ntobler/startracker/docs/arducam_imx462.md

# Arducam Starvis IMX462 Camera

Uses `Pivariety` driver from Arducam. Is part of the Raspberry Pi Kernel from `>6.1.21` on

https://docs.arducam.com/Raspberry-Pi-Camera/Pivariety-Camera/Introduction/
https://docs.arducam.com/Raspberry-Pi-Camera/Pivariety-Camera/IMX462/
https://docs.arducam.com/Raspberry-Pi-Camera/Pivariety-Camera/Quick-Start-Guide/
https://www.arducam.com/raspberry-pi-camera-pinout/
https://docs.arducam.com/Raspberry-Pi-Camera/Pivariety-Camera/PiCamera2-User-Guide/

# Raspberri pi camera API:
https://datasheets.raspberrypi.com/camera/picamera2-manual.pdf
https://github.com/raspberrypi/picamera2/blob/main/examples/stack_raw.py
