ntobler/startracker/docs/components.md

# Components

This document lists major components their specs and additional links.

Raspberry Pi Zero 2 W
- https://www.raspberrypi.com/products/raspberry-pi-zero-2-w/
- USD 16.50

SD Card:
- SanDisk Extreme UHS-I V30, 32 GB, microSDHC, U3

Camera
- Arcucam IMX462 Starvis
- https://www.uctronics.com/2mp-imx462-color-ultra-low-light-starvis-camera-module-with-141-h-wide-angle-m12-lens-for-raspberry-pi.html
- https://www.arducam.com/product/2mp-imx462-color-ultra-low-light-starvis-camera-module-with-141h-wide-angle-m12-lens-for-raspberry-pi/
- IMX462
- 1/2.8" (6.4mm diagonal)
- USD 39.99

Lens
- M12 12mm f2.0
- https://www.uctronics.com/arducam-12mm-m12-lens-m2512zh03-for-usb-camera.html
- https://aliexpress.com/item/1005004653999213.html
- 12mm f2.0
- max sensor size 1/2.5"
- USD 3.22

Lens Mount:
- Inner cutout: 12.5mm
- Screw-to-screw distance: 18mm
- Height: 12mm
- https://aliexpress.com/item/1005005308744888.html
- USD 0.80

Lens lock
- M12
- https://aliexpress.com/item/1005005929526811.html
- USD 1.21

https://www.aliexpress.com/item/32950560454.html

Cable
- 22pin MIPI FPC, 0.5mm pitch, 50mm length, Type B
- https://aliexpress.com/item/1005004140412156.html
- USD 1.82

Raspberry Pi Display
- https://aliexpress.com/item/32844614289.html
- USD 12.73

Raspberry Pi USP
- https://www.waveshare.com/ups-hat-c.htm
- USD 23.99

Total approx USD 100

# Enclosure:

Custom 3D printed parts

1/4" thread insert
- https://aliexpress.com/item/1005008462611857.html

# Rework with Radxa system

Radxa board
- https://aliexpress.com/item/1005008640313705.html
- USD 57.28

Radxa camera
- https://aliexpress.com/item/1005006991383002.html
- IMX415-Sensor
- 12.3 MP
- 1.45 um
- 1/2.8"
- USD 26.42
