ntobler/startracker/hardware/Startracker/Project Outputs for Startracker_mainboard/Release_A00/StartrackerA00_BOM.xlsx

Description | Designator | Footprint | #Column Name Error:' JLCPCB Part Number
Cap Cer SMD 100n 50V 10% 0603 X7R | C1, C5, C6, C7, C8, C10, C12, C14, C20, C21, C22, C35, C36, C37, C38, C39, C40, C41, C42, C48, C49, C50, C51, C52, C53, C54, C55 | C-0603_1608_095_L_RF
Cap Cer SMD 1u 16V 10% 0603 X7R | C2, C9, C18, C19, C32, C33, C34, C43, C44, C45 | C-0603_1608_095_L_RF
Cap Cer SMD 22u 25V 10% 1206 X5R | C3, C4, C15, C16, C17, C26, C27, C28, C29, C30, C31 | C-1206_3216_230_L_RF
Cap Cer SMD 22u 6.3V 20% 0603 X5R | C11, C13 | C-0603_1608_110_L_RF
Cap Cer SMD 22n 50V 10% 0603 X7R | C23, C24, C25 | C-0603_1608_095_L_RF
Cap Cer SMD 15p 50V 5% 0603 C0G | C46, C47 | C-0603_1608_095_L_RF
IC MCU Cortex-M4 256k Flash 128k RAM | D1 | UFQFPN48_N_RF
IC DRIVER Stepper 1.4A | D2, D3, D4 | QFN28_N_RF
IC Charger Li-Ion 1Cell | D5 | SOT23-6_N_RF
IC Protection Li-Ion | D6 | SOT23_N_RF
IC IMU 9-Axis Attitude Sensor | D7 | QFN24_N_RF
Crystal Oscillator 16MHz 10pF ±10ppm LCSC C112972 | G1 | G_3225_N_RF
IND 4.7uH 6.4A 4.9x4.9mm | L1 | L-0490X0490_N_RF
IND 4.7uH 2.9A 4x4mm | L2 | L-0400X0400_N_RF
<PCB DesignName Revision> | PCB1 | Dummy_PCB-Parameter_SM
Res SMD 10k 1% 0.1W 0603 | R1, R2, R3, R4, R7, R8, R10, R14, R20, R24, R25, R26, R27, R28, R30, R31, R34 | R-0603_1608_050_L_RF
Res SMD 5k1 1% 0.1W 0603 | R5, R6 | R-0603_1608_050_L_RF
Res SMD 1k 1% 0.1W 0603 | R9, R29 | R-0603_1608_050_L_RF
Res SMD 2k2 1% 0.1W 0603 | R11, R35, R36 | R-0603_1608_050_L_RF
Res SMD 100k 1% 0.1W 0603 | R12, R15, R17 | R-0603_1608_050_L_RF
Res SMD 100R 1% 0.1W 0603 | R13, R19 | R-0603_1608_050_L_RF
Res SMD 150k 1% 0.1W 0603 | R16 | R-0603_1608_050_L_RF
Res SMD 16k 1% 0.1W 0603 | R18 | R-0603_1608_050_L_RF
OLED Display I2C 128X64 0.96" | R21 | OLED_0.96
Res SMD 130k 1% 0.1W 0603 | R22 | R-0603_1608_050_L_RF
Res SMD 15k 1% 0.1W 0603 | R23 | R-0603_1608_050_L_RF
BUTTON tactile 12V 50mA | S1, S2, S3, S4 | K2-1808UN-A4SW-04
IC Boost Converter 1.8V-5.5V to 1.8-5.5V 2.1A | U1 | TSOT-23-8
IC Boost Converter 2.5V-5.5V upto 28V 1.5A | U2 | SOT23-5_N_RF
IC REG LDO 3.3V 200mA | U3 | SOT23_N_RF
LED RED LTST-C190KDKT-10A 0603 | V1 | LED-0603_1608_Red_L_RF
MOSFET PCH -2A 20V | V2, V4 | SOT23_N_RF
TRANS SMD NPN 45V 0.1A BC847B SOT23 | V3, V5 | SOT23_L_RF
Diode Schottky 40V 1A SMA | V6 | SMA_DO214AC_L_RF
RGB LED SPI Interface | V7 | V_2020_P6_N_RF
Diode Schottky 1mA 40 Volt | V13, V14 | SOD123_L_RF
CONN USB-C 16pin | X1 | 105450-0101
CONN HEADER 4POS_JST_B4B-XH | X3, X4, X6, X8 | X-0124X0057-R_M04_P0250_JST_B4B-XH-A
CONN HEADER 2POS_JST_B2B-XH | X5 | X-0074X0057-R_M02_P0250_JST_B2B-XH-A
