ntobler/startracker/hardware/Startracker/Project Outputs for Startracker_mainboard/Release_A00/Startracker_A00_SCH.PDF

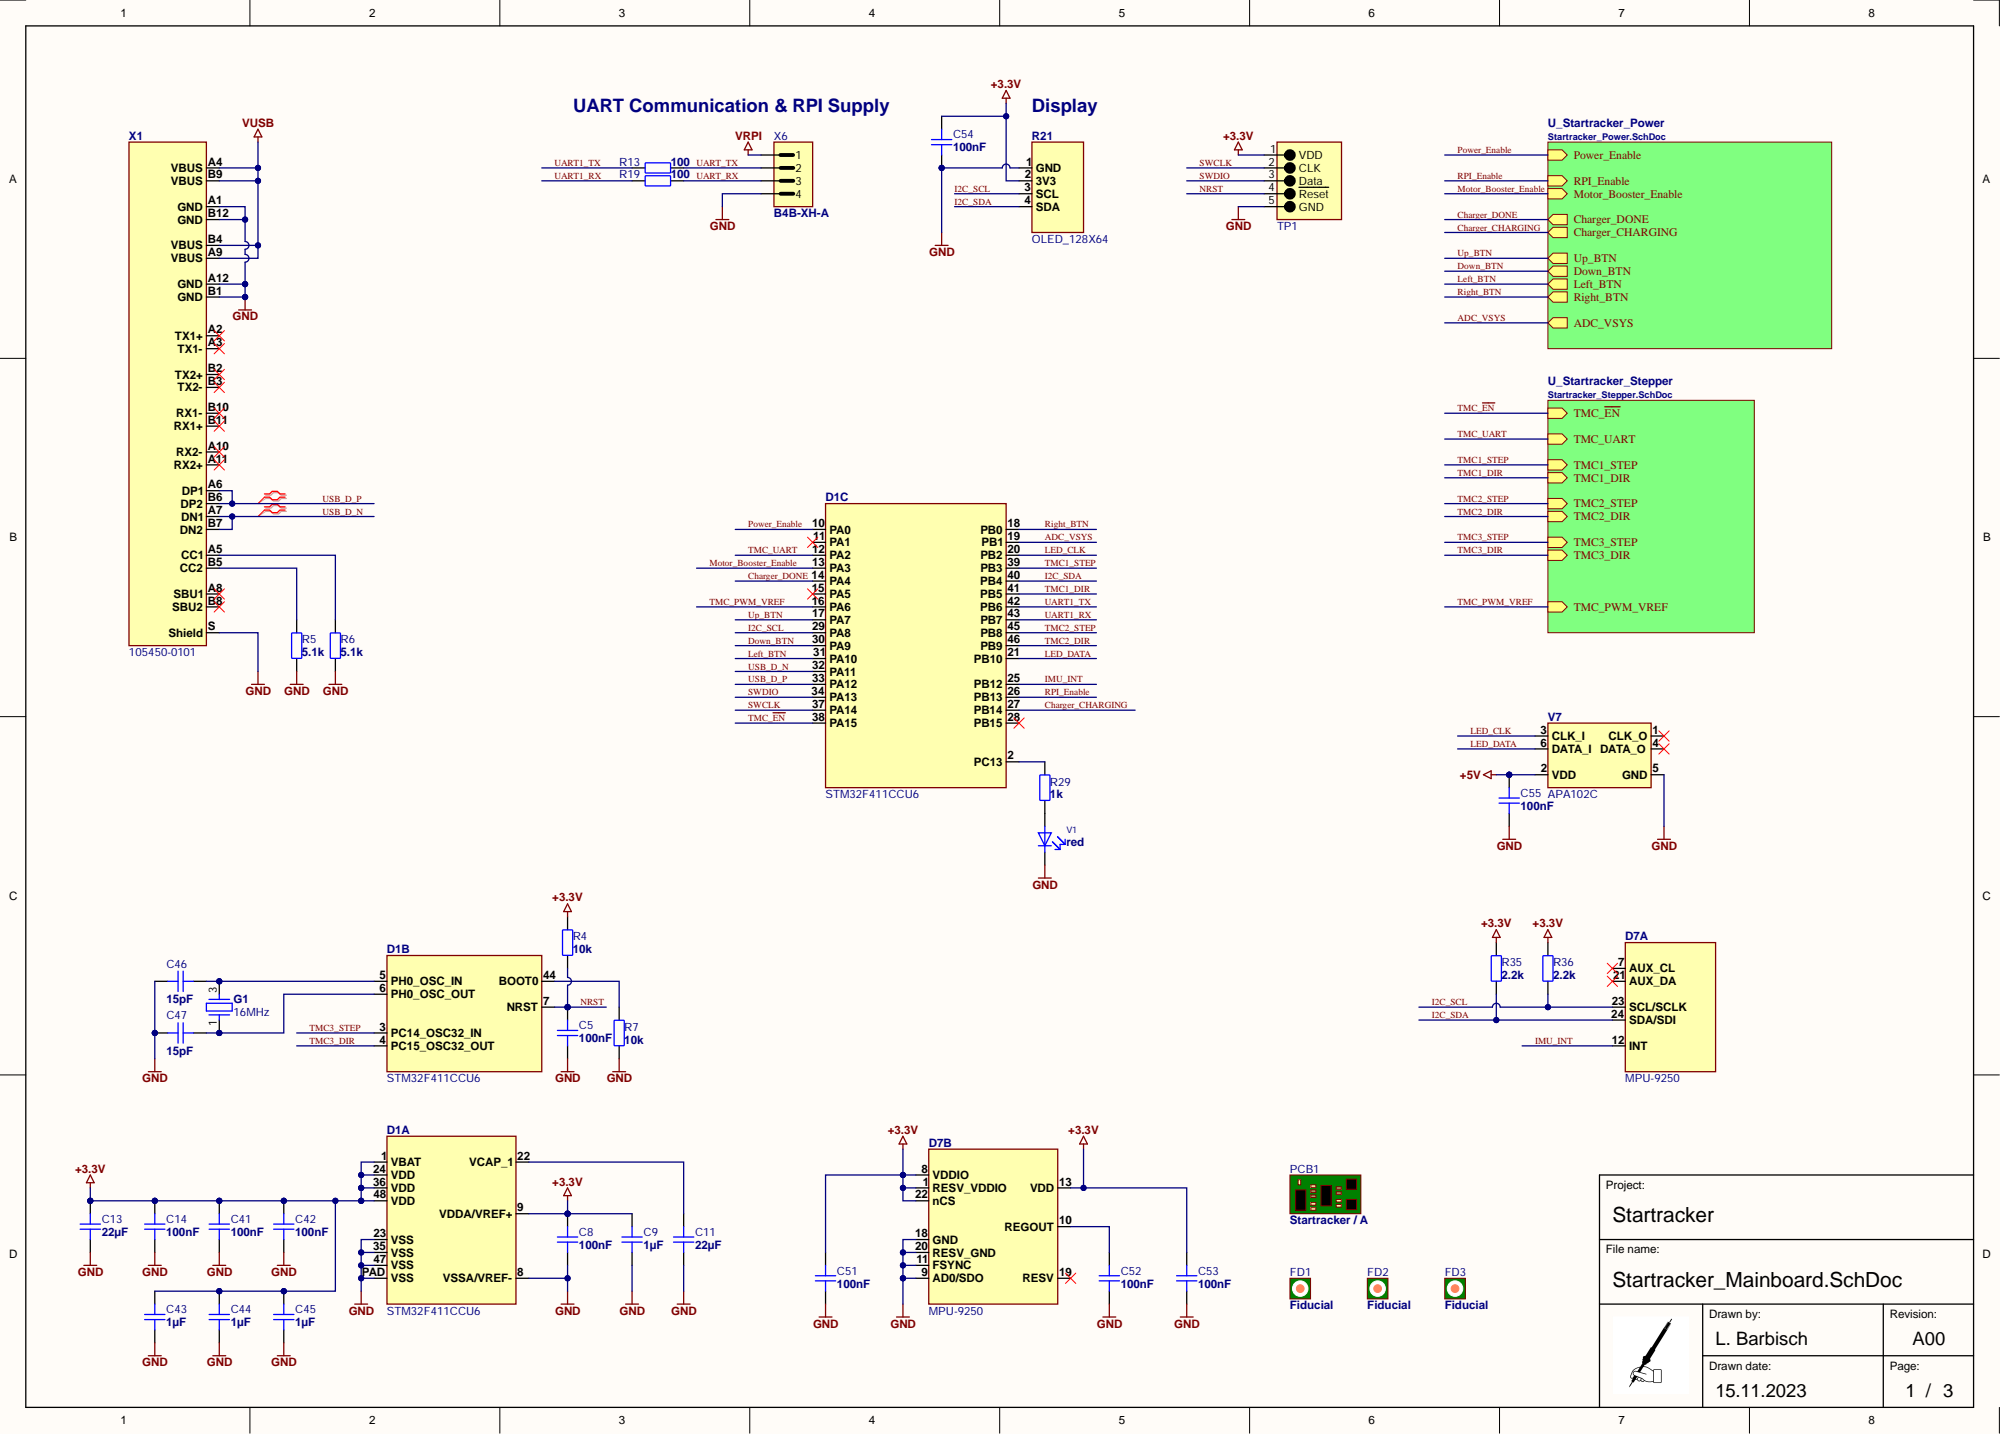
[picture p3: page 1]

UART Communication & RPI Supply

Drawn by: L. Barbisch | Revision: A00

Drawn date: 15.11.2023 | Page:

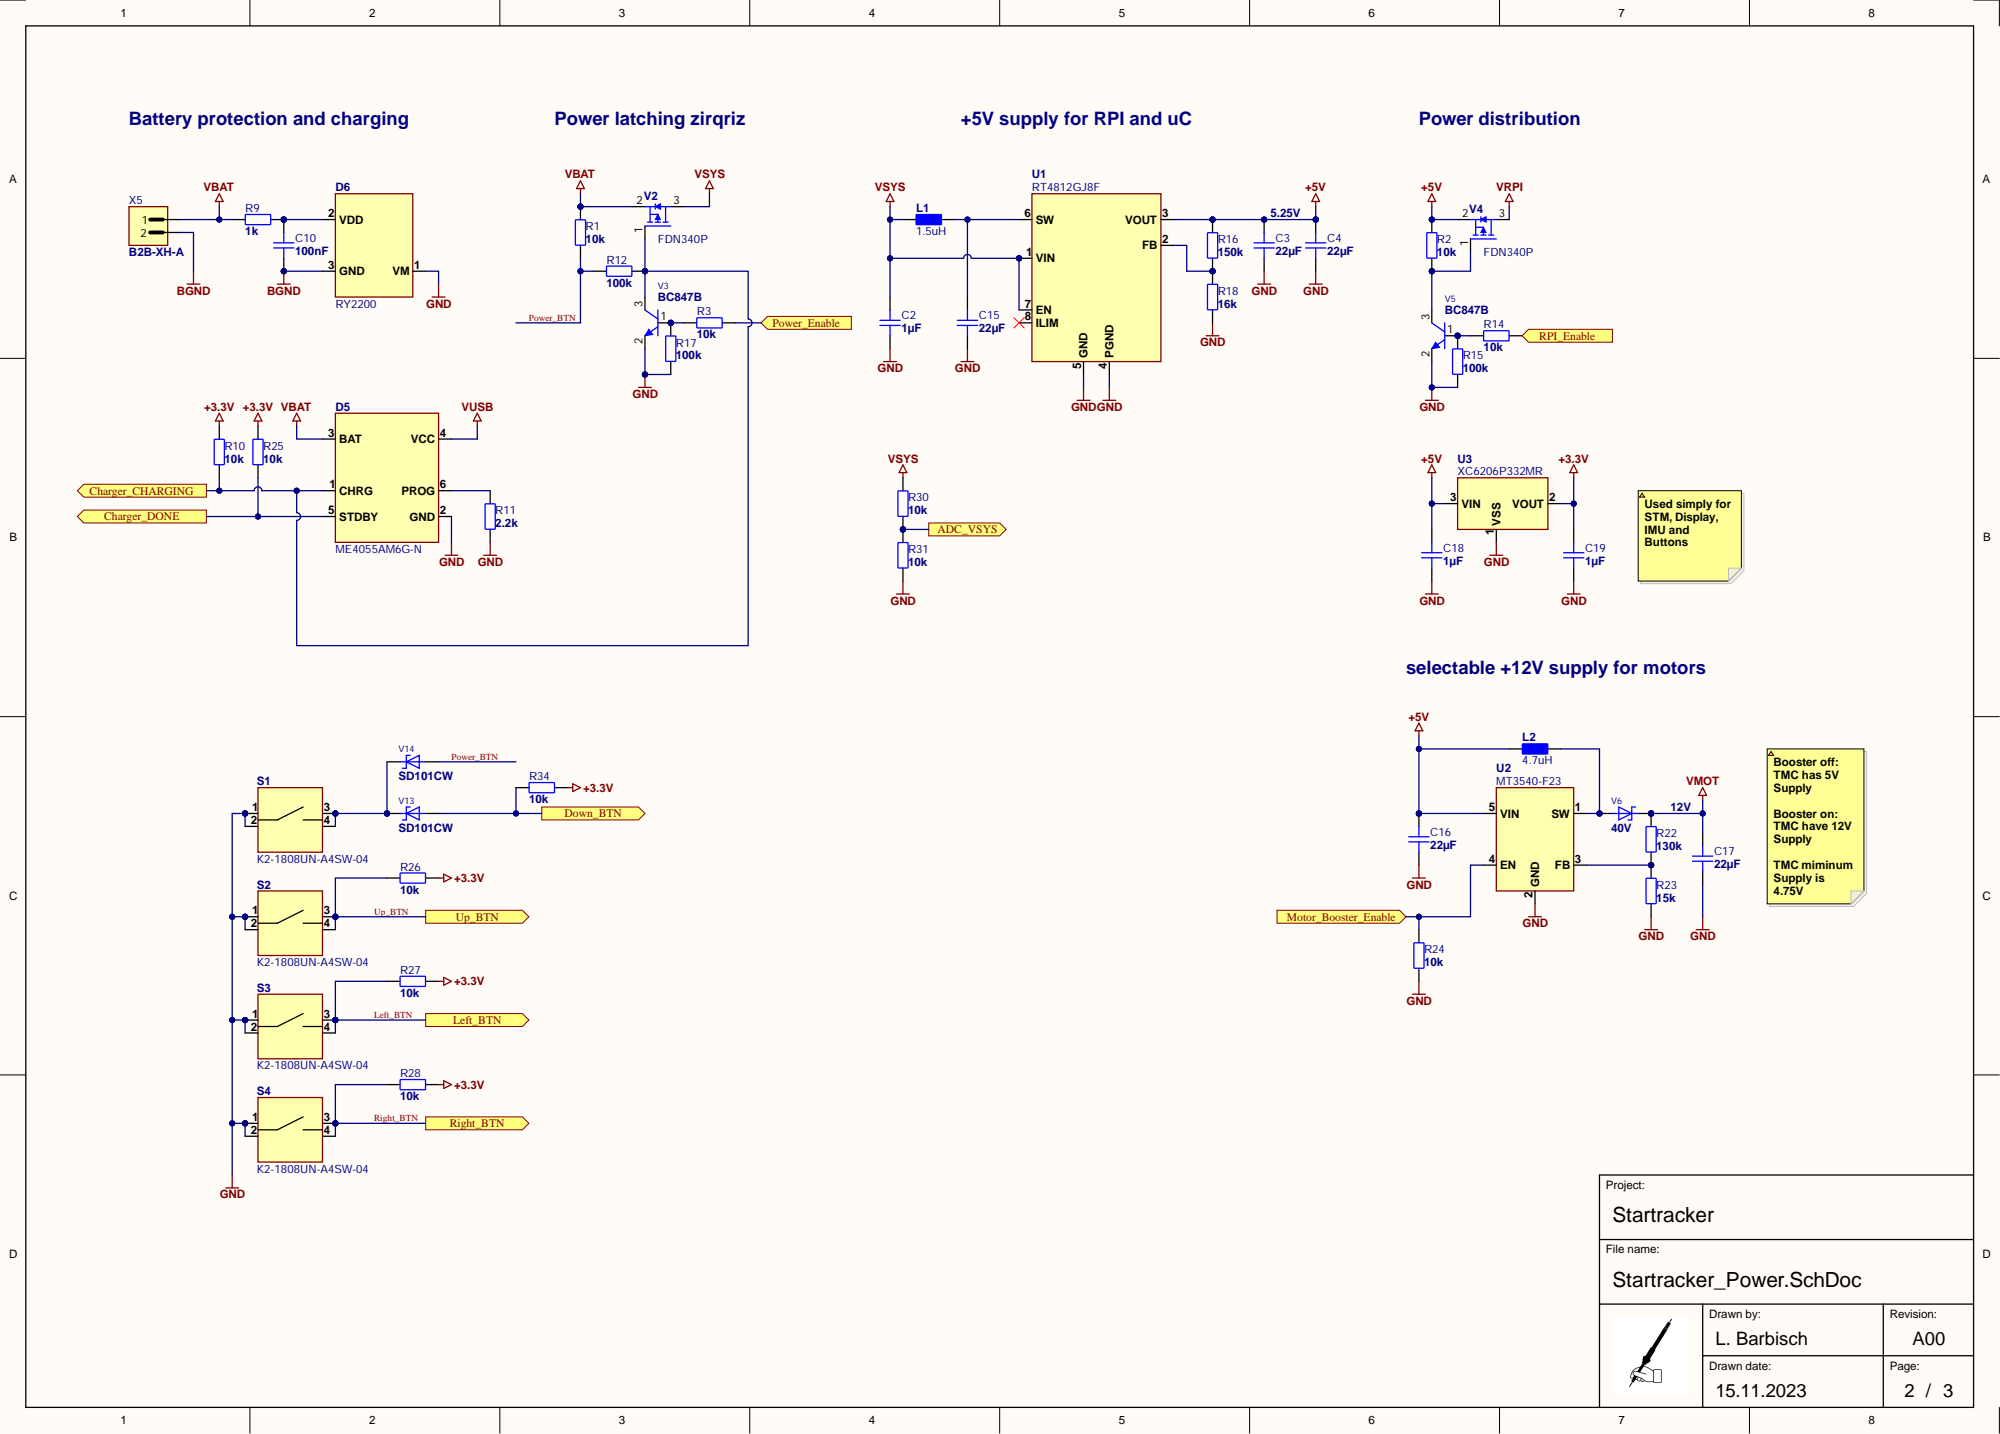
[picture p4: page 2]

Battery protection and charging

+5V supply for RPI and uC

selectable +12V supply for motors

Revision: A00

15.11.2023 | Page:

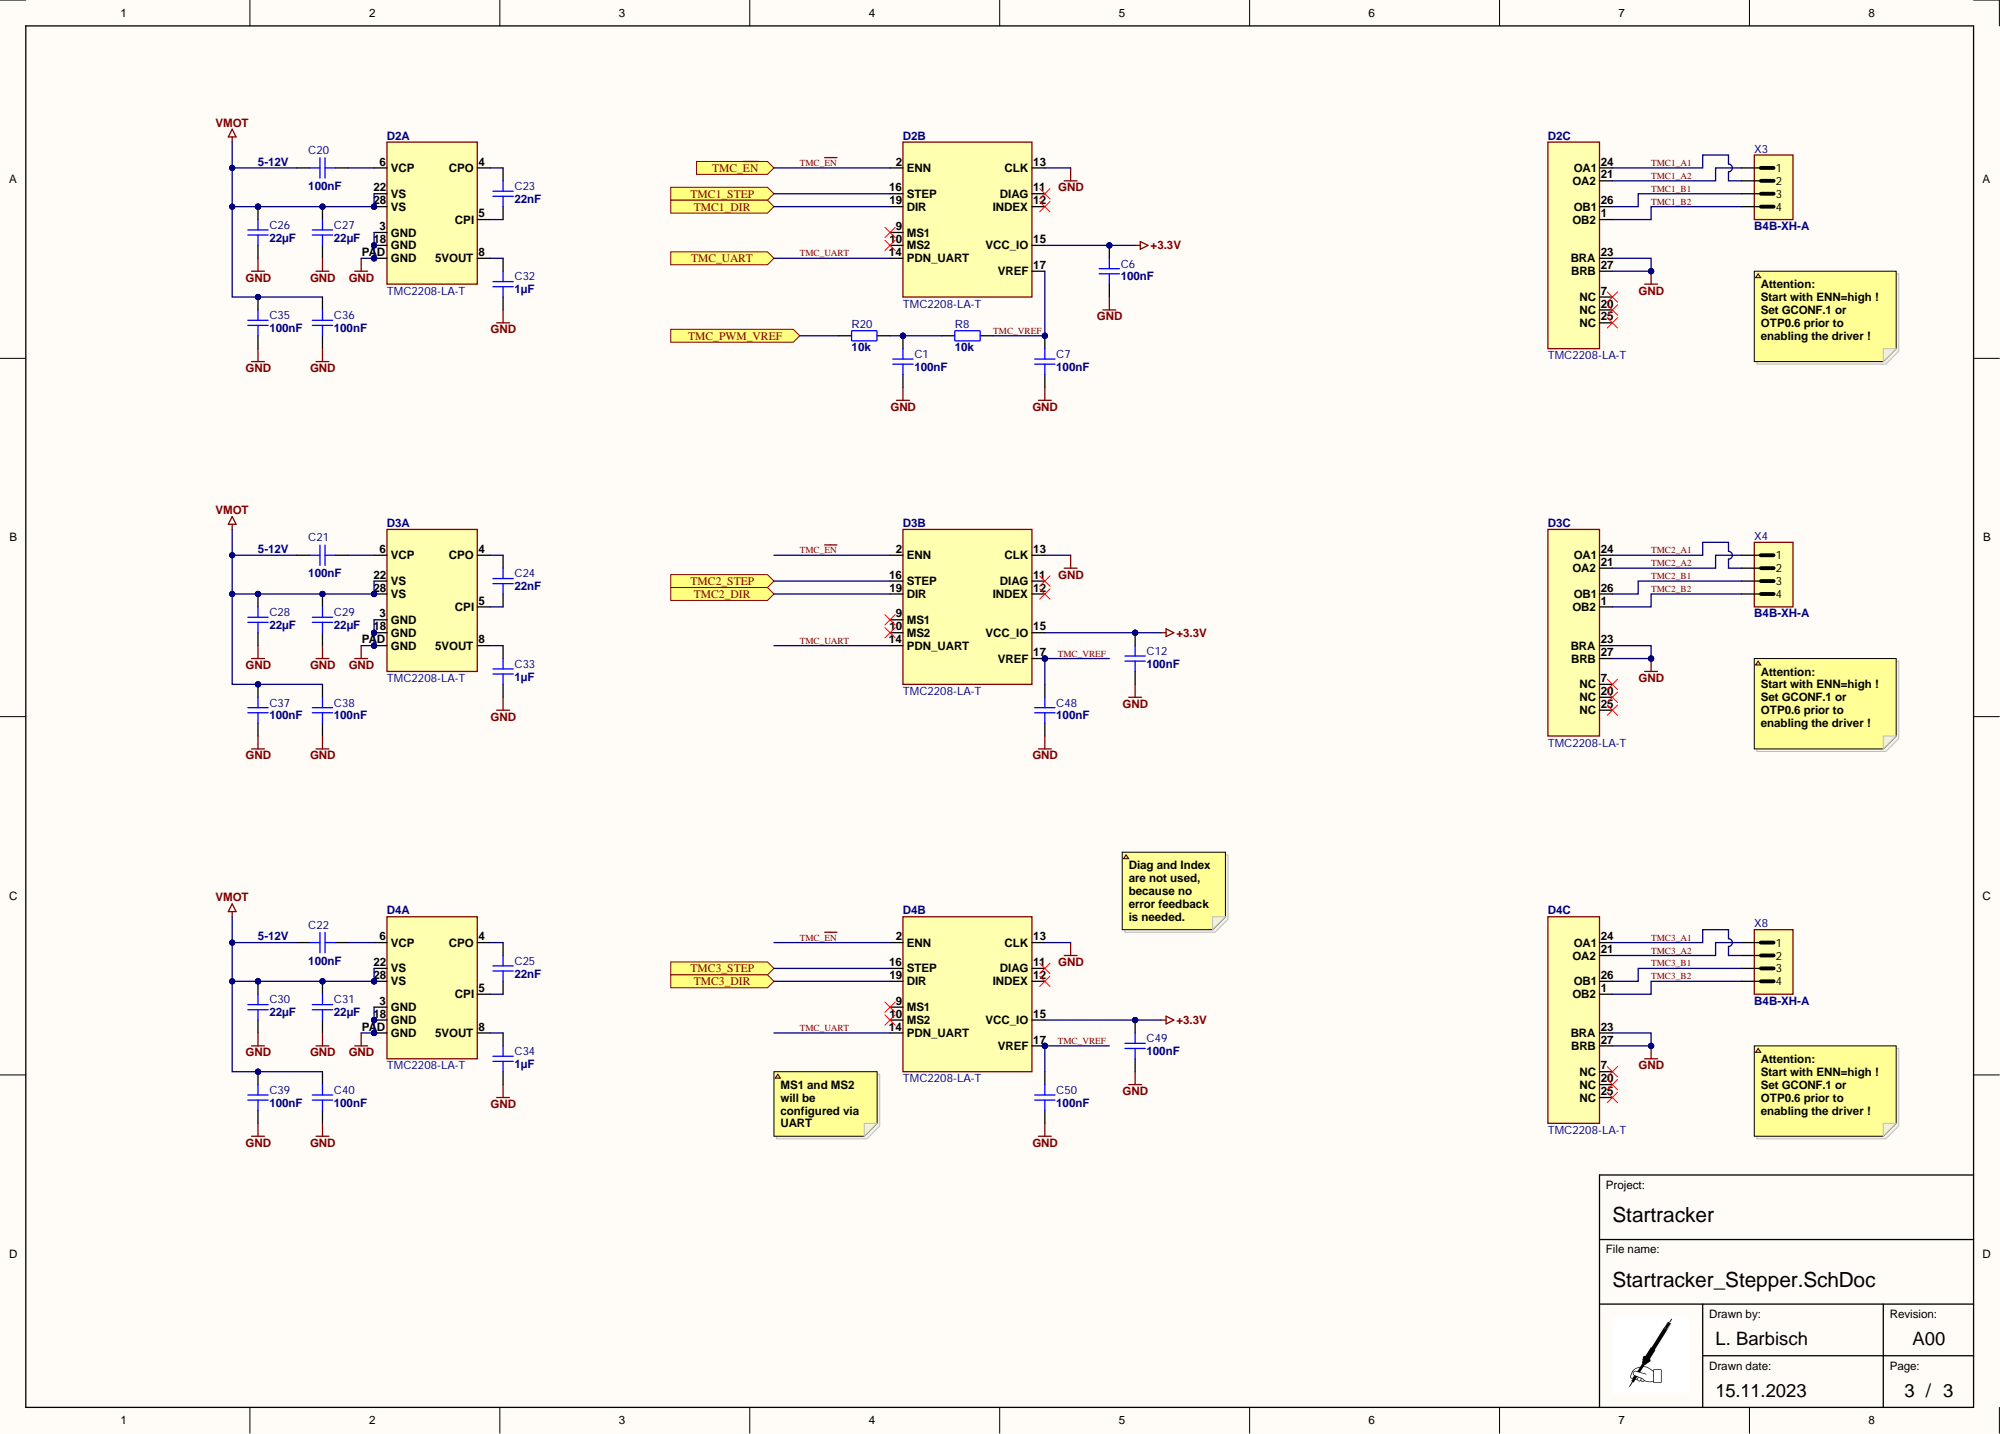
[picture p5: page 3]

Attention
Start with ENN=high
Set GCONF.1 or
OTP0.6 prior to
enabling the driver

Revision : A00 3

Page : /
