ntobler/startracker/hardware/Startracker/Project Outputs for Startracker_mainboard/Release_A00/Startracker_A00_Documentation.PDF

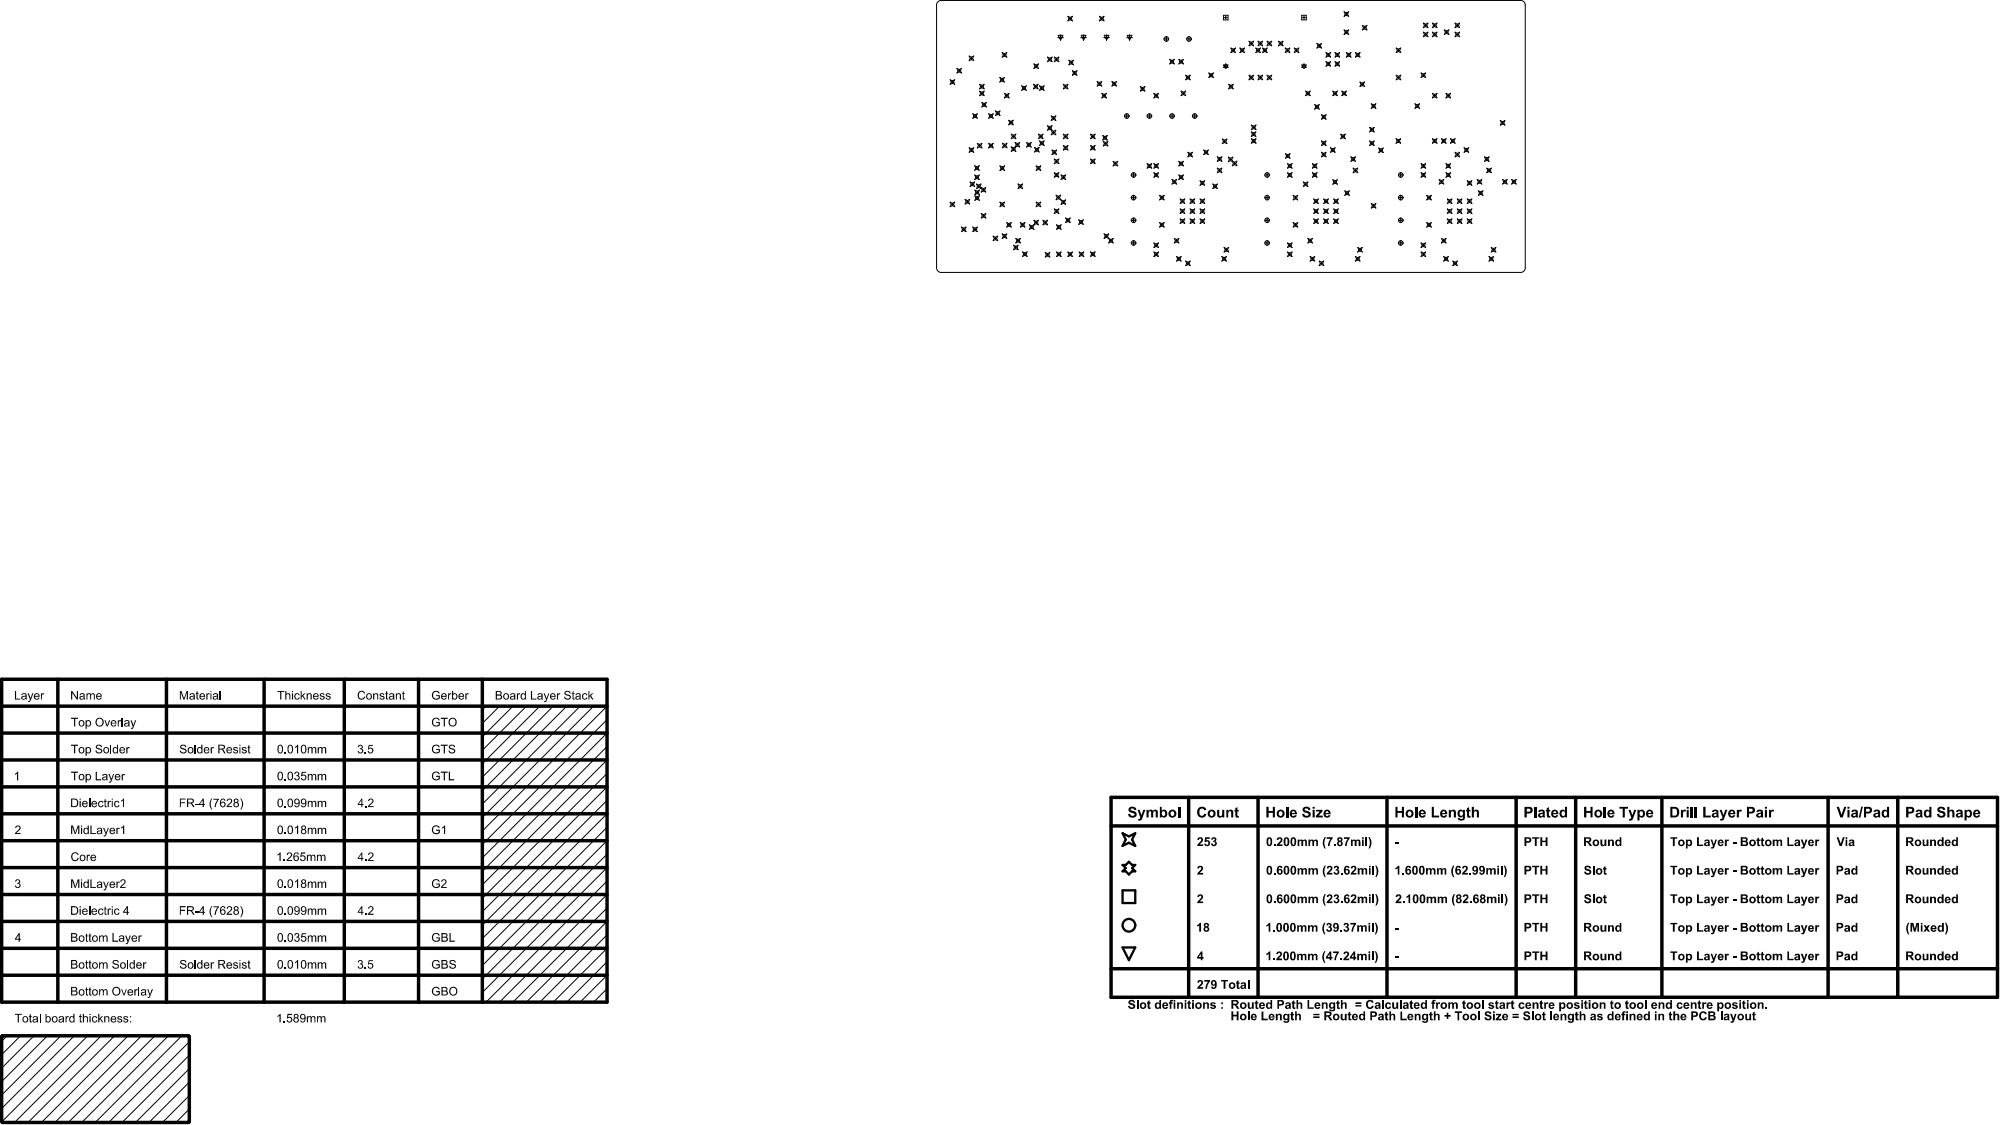
[picture p6: page 2]

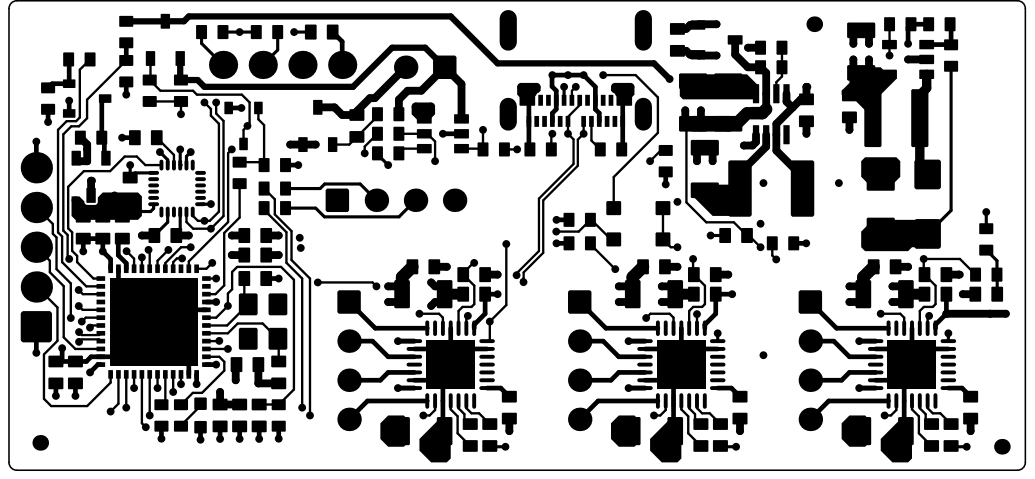
[picture p7: page 3]

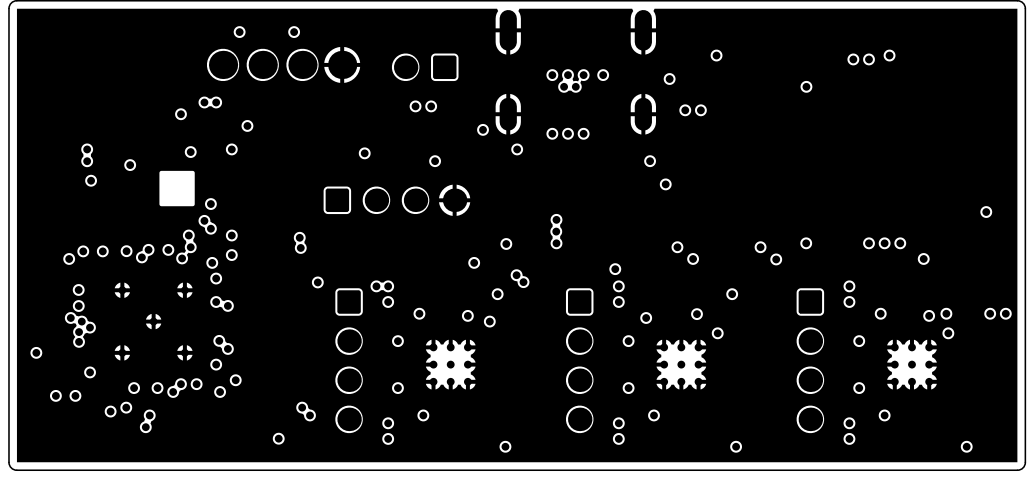
[picture p8: page 4]

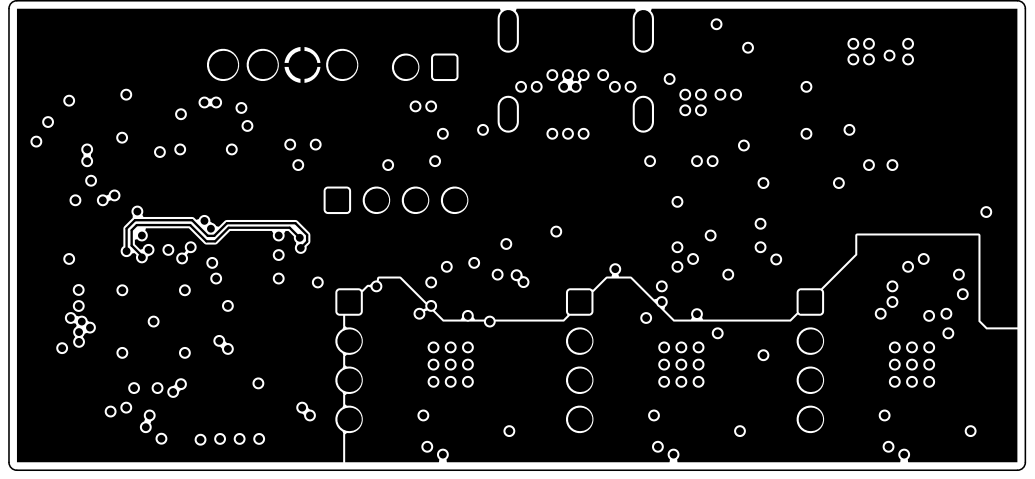
[picture p9: page 5]

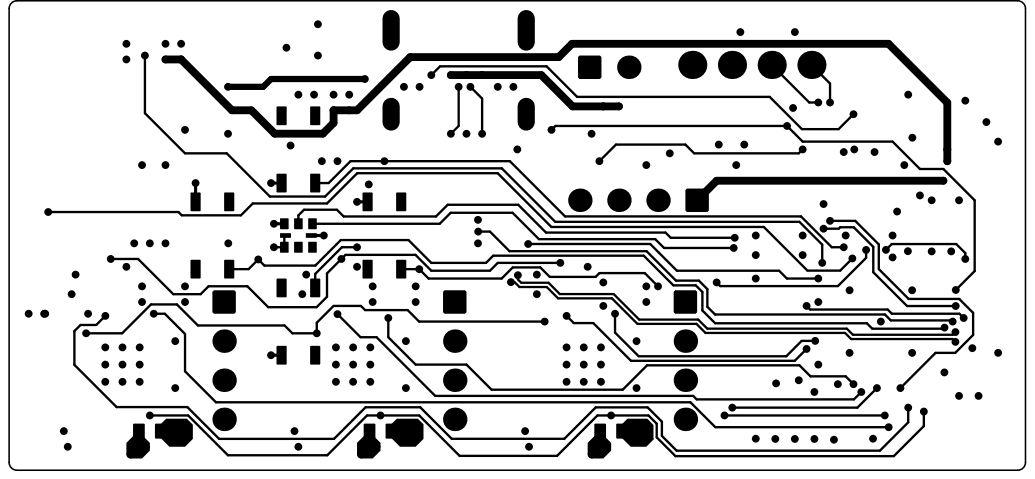
[picture p10: page 8]
