ntobler/startracker/hardware/Startracker/Project Outputs for Startracker_mainboard/Release_A00/Startracker_A00_Testpoints.PDF

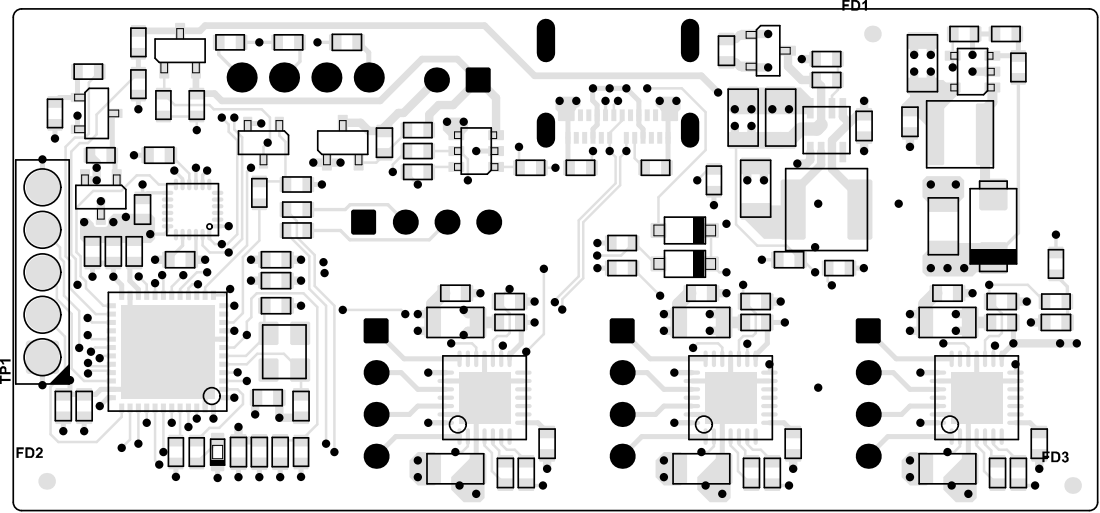
[picture p17: page 1]

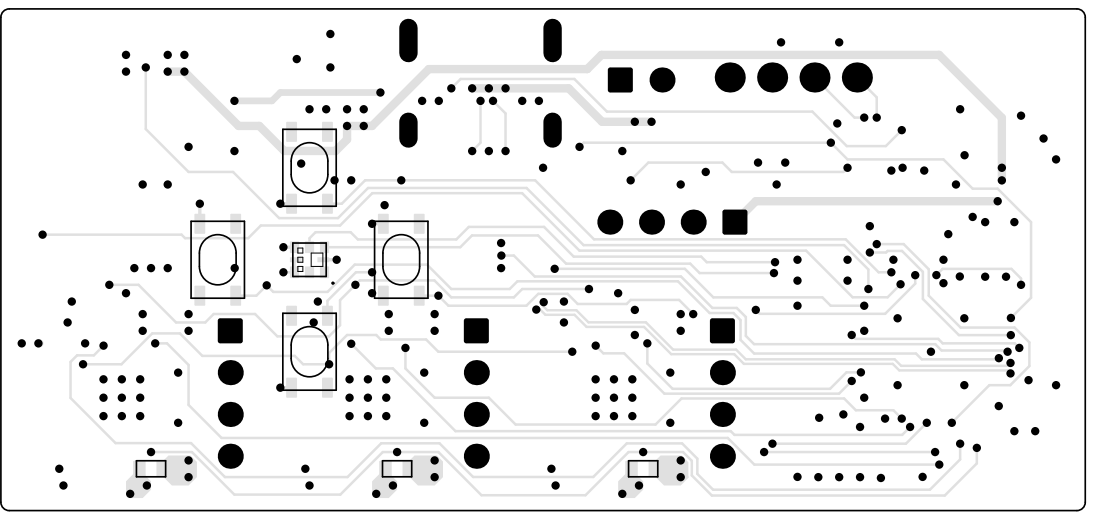
[picture p18: page 2]
