ntobler/startracker/(list of files, drawings)

Other design files:
hardware/Startracker/Startracker_mainboard.PrjPcb
hardware/Startracker/Startracker_Mainboard.SchDoc
hardware/Startracker/Startracker_Power.SchDoc
hardware/Startracker/Startracker_Stepper.SchDoc
