ntobler/startracker/src/lib.rs

use numpy::{self, PyArrayMethods, PyUntypedArrayMethods, ToPyArray};
use pyo3::Python;
use pyo3::{
    exceptions::PyRuntimeError, pyclass, pyfunction, pymethods, pymodule, types::PyModule,
    wrap_pyfunction, Bound, PyResult,
};
use std::usize;

use crate::optim::OptimizableProblem;

mod common_axis;
mod optim;
mod poisson_disk;
mod quat_optim;
mod starcal;
mod stargradcal;
mod testingutils;
mod utils;

pub mod cam;

#[pymodule]
fn libstartracker(m: &Bound<'_, PyModule>) -> PyResult<()> {
    m.add_function(wrap_pyfunction!(starcal_calibrate, m)?)?;
    m.add_function(wrap_pyfunction!(starcal_objective_function, m)?)?;
    m.add_function(wrap_pyfunction!(stargradcal_calibrate, m)?)?;
    m.add_function(wrap_pyfunction!(stargradcal_objective_function, m)?)?;
    m.add_function(wrap_pyfunction!(find_common_axis, m)?)?;
    m.add_function(wrap_pyfunction!(even_spaced_indices, m)?)?;
    m.add_class::<StarcalCalibrationResult>()?;
    m.add_class::<CameraConfig>()?;
    m.add_class::<Camera>()?;
    m.add_function(wrap_pyfunction!(estimate_gyro_params, m)?)?;
    m.add_function(wrap_pyfunction!(filter_step, m)?)?;
    Ok(())
}

#[pyclass]
pub struct StarcalCalibrationResult {
    inner: starcal::CalibrationResult,
}

#[pymethods]
impl StarcalCalibrationResult {
    #[getter]
    pub fn params(&self) -> Vec<f64> {
        self.inner.params.to_vec()
    }

    #[getter]
    pub fn rms_error(&self) -> f64 {
        self.inner.rms_error
    }

    // Prevent construction from Python
    #[new]
    fn new() -> PyResult<Self> {
        Err(PyRuntimeError::new_err(
            "StarcalCalibrationResult cannot be constructed from Python",
        ))
    }
}

#[pyfunction]
fn starcal_objective_function<'py>(
    py: Python<'py>,
    params: [f64; starcal::PARAM_COUNT],
    image_points: numpy::PyReadonlyArray2<'py, f32>,
    object_points: numpy::PyReadonlyArray2<'py, f32>,
) -> PyResult<(
    Bound<'py, numpy::PyArray1<f64>>,
    Bound<'py, numpy::PyArray2<f64>>,
)> {
    let image_points_view = numpy_to_slice_2d(&image_points)?;
    let object_points_view = numpy_to_slice_2d(&object_points)?;
    let mut problem: starcal::CameraCalibrationProblem<'_> =
        starcal::CameraCalibrationProblem::new(&params, image_points_view, object_points_view);

    problem.calc_jacobian();
    problem.calc_residuals();

    let residuals = problem.get_residuals().as_slice().to_pyarray_bound(py);
    let jacobian_array = problem.get_jacobian();
    let jacobian_flat = jacobian_array.as_slice().to_pyarray_bound(py);
    let jacobian = jacobian_flat.reshape((jacobian_array.ncols(), jacobian_array.nrows()))?;
    Ok((residuals, jacobian))
}

#[pyfunction]
fn starcal_calibrate<'py>(
    image_points: numpy::PyReadonlyArray2<'py, f32>,
    object_points: numpy::PyReadonlyArray2<'py, f32>,
    image_size: [usize; 2],
    intrinsic_guess: Option<numpy::PyReadonlyArray2<'py, f64>>,
    dist_coefs_guess: Option<numpy::PyReadonlyArray1<'py, f64>>,
    tol: Option<f64>,
    max_iter: Option<usize>,
) -> PyResult<StarcalCalibrationResult> {
    let image_points_view = numpy_to_slice_2d(&image_points)?;
    let object_points_view = numpy_to_slice_2d(&object_points)?;

    let intrinsic: [[f64; 3]; 3] = if let Some(guess) = intrinsic_guess {
        if guess.shape() != [3, 3] {
            return Err(PyRuntimeError::new_err(
                "intrinsic_guess must have shape [3, 3]",
            ));
        }
        let slice = guess.as_slice()?;
        [
            [slice[0], 0.0, slice[2]],
            [0.0, slice[4], slice[5]],
            [0.0, 0.0, 1.0],
        ]
    } else {
        let width = image_size[0] as f64;
        let height = image_size[1] as f64;
        let min_z = object_points_view
            .iter()
            .map(|p| p[2])
            .fold(f32::INFINITY, f32::min) as f64;
        let focal_length =
            f64::sqrt(width * width + height * height) / f64::tan(f64::acos(min_z)) / 2.0;
        [
            [focal_length, 0.0, width / 2.0],
            [0.0, focal_length, height / 2.0],
            [0.0, 0.0, 1.0],
        ]
    };
    let dist_coefs: [f64; 5] = if let Some(guess) = dist_coefs_guess {
        let slice = guess.as_slice()?;
        if slice.len() != 5 {
            return Err(PyRuntimeError::new_err(
                "dist_coefs_guess must have length 5",
            ));
        }
        [slice[0], slice[1], slice[2], slice[3], slice[4]]
    } else {
        [0.0, 0.0, 0.0, 0.0, 0.0]
    };

    let tol_value = match tol {
        Some(v) => v,
        None => 1e-4,
    };

    let max_iter_value = match max_iter {
        Some(v) => v,
        None => 20,
    };

    let result = starcal::calibrate(
        image_points_view,
        object_points_view,
        &intrinsic,
        &dist_coefs,
        tol_value,
        max_iter_value,
    );

    Ok(StarcalCalibrationResult { inner: result })
}

#[pyfunction]
fn stargradcal_objective_function<'py>(
    py: Python<'py>,
    image_points: numpy::PyReadonlyArray2<'py, f32>,
    image_gradients: numpy::PyReadonlyArray2<'py, f32>,
    intrinsic_guess: numpy::PyReadonlyArray2<'py, f64>,
    dist_coef_guess: f64,
    theta_guess: f64,
    epsilon_guess: f64,
) -> PyResult<(
    Bound<'py, numpy::PyArray1<f64>>,
    Bound<'py, numpy::PyArray2<f64>>,
)> {
    let image_points_view = numpy_to_slice_2d(&image_points)?;
    let image_gradients_view = numpy_to_slice_2d(&image_gradients)?;

    if intrinsic_guess.shape() != [3, 3] {
        return Err(PyRuntimeError::new_err(
            "intrinsic_guess must have shape [3, 3]",
        ));
    }
    let slice = intrinsic_guess.as_slice()?;
    let intrinsic = [
        [slice[0], slice[1], slice[2]],
        [slice[3], slice[4], slice[5]],
        [slice[6], slice[7], slice[8]],
    ];

    let params = [
        f64::tan(epsilon_guess * 0.25),
        f64::tan(theta_guess * 0.25),
        intrinsic[0][0],
        intrinsic[0][2],
        intrinsic[1][1],
        intrinsic[1][2],
        dist_coef_guess,
    ];

    let mut problem: stargradcal::StarGradCalibrationProblem<'_> =
        stargradcal::StarGradCalibrationProblem::new(
            &params,
            image_points_view,
            image_gradients_view,
        );

    problem.calc_jacobian();
    problem.calc_residuals();

    let residuals = problem.get_residuals().as_slice().to_pyarray_bound(py);
    let jacobian_flat = problem.get_jacobian().as_slice().to_pyarray_bound(py);
    let jacobian = jacobian_flat
        .reshape((
            problem.get_jacobian().ncols(),
            problem.get_jacobian().nrows(),
        ))
        .expect("Shape mismatch in jacobian reshape");
    Ok((residuals, jacobian))
}

#[pyfunction]
fn find_common_axis<'py>(
    py: Python<'py>,
    rot_mats: numpy::PyReadonlyArray2<'py, f64>,
    tol: f64,
    max_iter: usize,
) -> PyResult<(
    Bound<'py, numpy::PyArray1<f64>>,
    Bound<'py, numpy::PyArray1<f64>>,
    Bound<'py, numpy::PyArray1<f64>>,
    f64,
)> {
    let rot_mats_view: &[[f64; 9]] = numpy_to_slice_2d(&rot_mats)?;
    let (axis, mrp, residuals, estimated_std_rad) =
        common_axis::find_common_axis(rot_mats_view, tol, max_iter)
            .map_err(PyRuntimeError::new_err)?;
    let axis_np = axis.as_slice().to_pyarray_bound(py);
    let mrp_np = mrp.as_slice().to_pyarray_bound(py);
    let residuals_np = residuals.as_slice().to_pyarray_bound(py);
    Ok((axis_np, mrp_np, residuals_np, estimated_std_rad))
}

#[pyfunction]
fn stargradcal_calibrate<'py>(
    py: Python<'py>,
    image_points: numpy::PyReadonlyArray2<'py, f32>,
    image_gradients: numpy::PyReadonlyArray2<'py, f32>,
    intrinsic_guess: numpy::PyReadonlyArray2<'py, f64>,
    dist_coef_guess: f64,
    theta_guess: f64,
    epsilon_guess: f64,
    tol: f64,
    max_iter: usize,
) -> PyResult<(
    Bound<'py, numpy::PyArray2<f64>>,
    f64,
    f64,
    f64,
    Bound<'py, numpy::PyArray1<f64>>,
)> {
    let image_points_view = numpy_to_slice_2d(&image_points)?;
    let image_gradients_view = numpy_to_slice_2d(&image_gradients)?;

    if intrinsic_guess.shape() != [3, 3] {
        return Err(PyRuntimeError::new_err(
            "intrinsic_guess must have shape [3, 3]",
        ));
    }
    let slice = intrinsic_guess.as_slice()?;
    let intrinsic = [
        [slice[0], 0.0, slice[2]],
        [0.0, slice[4], slice[5]],
        [0.0, 0.0, 1.0],
    ];

    let (intrinsic, dist_coef, theta, epsilon, residuals) = stargradcal::calibrate(
        image_points_view,
        image_gradients_view,
        &intrinsic,
        dist_coef_guess,
        theta_guess,
        epsilon_guess,
        tol,
        max_iter,
    );

    let intrinsic_numpy_flat = intrinsic.as_slice().to_pyarray_bound(py);
    let residuals_numpy = residuals.as_slice().to_pyarray_bound(py);
    // nalgebra is row-major, numpy expects column-major, so we need to transpose
    let intrinsic_numpy = intrinsic_numpy_flat
        .reshape((3, 3))
        .expect("Shape mismatch in intrinsic reshape");

    Ok((intrinsic_numpy, dist_coef, theta, epsilon, residuals_numpy))
}

#[pyfunction]
fn even_spaced_indices<'py>(
    py: Python<'py>,
    points: numpy::PyReadonlyArray2<'py, f32>,
    n_samples: usize,
    rng_seed: u64,
) -> PyResult<Bound<'py, numpy::PyArray1<usize>>> {
    let points_view = numpy_to_slice_2d(&points)?;
    let accepted_indices = poisson_disk::even_spaced_indices(&points_view, n_samples, rng_seed);
    Ok(accepted_indices.as_slice().to_pyarray_bound(py))
}

fn numpy_to_slice_2d<'py, T: numpy::Element + Copy, const L: usize>(
    vectors: &'py numpy::PyReadonlyArray2<'py, T>,
) -> PyResult<&'py [[T; L]]> {
    if !vectors.is_c_contiguous() || vectors.ndim() != 2 || vectors.shape()[1] != L {
        return Err(PyRuntimeError::new_err(format!(
            "vectors must be a c_contiguous array with shape=[n, {}]",
            L
        )));
    }
    let slice = vectors.as_slice()?;
    Ok(unsafe { std::slice::from_raw_parts(slice.as_ptr() as *const [T; L], slice.len() / L) })
}

#[pyclass]
struct CameraConfig {
    inner: cam::CameraConfig,
}

#[pymethods]
impl CameraConfig {
    #[new]
    fn new(
        analogue_gain: u32,
        digital_gain: u32,
        exposure_us: u32,
        binning: u32,
    ) -> PyResult<Self> {
        let config = cam::CameraConfig {
            analogue_gain,
            digital_gain,
            exposure_us,
            binning,
        };
        Ok(CameraConfig { inner: config })
    }
}

#[pyclass]
struct Camera {
    inner: cam::Camera,
}

#[pymethods]
impl Camera {
    #[new]
    fn new(config: &CameraConfig) -> PyResult<Self> {
        let camera = cam::Camera::new(&config.inner).map_err(PyRuntimeError::new_err)?;
        Ok(Camera { inner: camera })
    }

    pub fn set_config(&mut self, config: &CameraConfig) {
        self.inner.set_config(&config.inner)
    }

    pub fn capture<'py>(&mut self, py: Python<'py>) -> PyResult<Bound<'py, numpy::PyArray2<u8>>> {
        let frame: cam::Frame<u8> = self.inner.capture().map_err(PyRuntimeError::new_err)?;
        let np_array = frame.data_row_major.to_pyarray_bound(py);
        let np_array = np_array
            .reshape((frame.height, frame.width))
            .expect("Shape mismatch in reshape");
        Ok(np_array)
    }
}

#[pyfunction]
fn estimate_gyro_params<'py>(
    py: Python<'py>,
    q_0: [f64; 4],
    q_1: [f64; 4],
    omega_t: numpy::PyReadonlyArray2<'py, f64>,
    scales: [f64; 3],
    biases: [f64; 3],
    delta_t: f64,
) -> PyResult<(
    Bound<'py, numpy::PyArray1<f64>>,
    Bound<'py, numpy::PyArray2<f64>>,
    Bound<'py, numpy::PyArray1<f64>>,
)> {
    let omega_t_view: &[[f64; 3]] = numpy_to_slice_2d(&omega_t)?;
    let (residuals, jacobian, q_x) =
        quat_optim::objective_function(&q_0, &q_1, omega_t_view, scales, biases, delta_t);

    let residuals_np = residuals.as_slice().to_pyarray_bound(py);
    let jacobian_np = jacobian.transpose().as_slice().to_pyarray_bound(py);
    let jacobian_np = jacobian_np.reshape((jacobian.nrows(), jacobian.ncols()))?;
    let q_x_np = q_x.as_slice().to_pyarray_bound(py);

    Ok((residuals_np, jacobian_np, q_x_np))
}

#[pyfunction]
fn filter_step<'py>(
    py: Python<'py>,
    q_0: [f64; 4],
    q_1: [f64; 4],
    omega_t: numpy::PyReadonlyArray2<'py, f64>,
    scales: [f64; 3],
    biases: [f64; 3],
    delta_t: f64,
    lamb: f64,
    alpha: f64,
    trust_region: f64,
) -> PyResult<(
    Bound<'py, numpy::PyArray1<f64>>,
    Bound<'py, numpy::PyArray1<f64>>,
)> {
    let omega_t_view: &[[f64; 3]] = numpy_to_slice_2d(&omega_t)?;
    let (scales, biases) = quat_optim::filter_step(
        &q_0,
        &q_1,
        omega_t_view,
        scales,
        biases,
        delta_t,
        lamb,
        alpha,
        trust_region,
    );

    let scales_np = scales.as_slice().to_pyarray_bound(py);
    let biases_np = biases.as_slice().to_pyarray_bound(py);
    Ok((scales_np, biases_np))
}
