ntobler/startracker/startracker/communication.py

"""Module to handle serial communication."""

import abc
import contextlib
import dataclasses
import enum
import logging
import pathlib
import struct
from collections.abc import Sequence
from typing import Any, Generic, Literal, Optional, TypeAlias, TypeVar, Union

import numpy as np
import serial
import serial.serialutil
from typing_extensions import Self, override


class CommunicatinoError(Exception):
    """Base class for communication errors."""


class CommunicationTimeoutError(CommunicatinoError):
    """Raised when a timeout happens during communication."""


class CRCError(CommunicatinoError):
    """Raised when a CRC check fails."""


def calc_crc_ccitt(data: bytes) -> int:
    """Calculate CRC-16/CCITT-FALSE of the data.

    Poly=0x1021, Init=0xFFFF, RefIn=False, RefOut=False, XorOut=0x0000

    Args:
        data: input data

    Returns:
        int: crc of the data
    """
    crc = 0xFFFF
    for x in data:
        crc ^= x << 8
        for _ in range(8):
            crc = (crc * 2) ^ 0x1021 if crc & 0x8000 else crc * 2
    return crc & 0xFFFF


def calc_crc_ibm(data: bytes) -> int:
    """Calculate CRC-16-IBM of the data as used in MODBUS .

    Poly=0x8005, Init=0xFFFF, RefIn=True, RefOut=True, XorOut=0x0000

    Args:
        data: input data

    Returns:
        int: crc of the data
    """
    crc = 0xFFFF
    for x in data:
        crc ^= x
        for _ in range(8):
            crc = (crc // 2) ^ 0xA001 if crc & 0x0001 else crc // 2
    return crc & 0xFFFF


class PacketHandler(serial.Serial):
    """Receive and send protocol packets.

    Properties:
    - Big endian

    Packet structure
    - 1 cmd_id byte
    - 1 length byte, evaluates to n
    - n payload bytes
    - 2 crc bytes of payload only (crc16)
    """

    def __init__(self, ser: serial.Serial) -> None:
        self._ser = ser

    def read_cmd(self) -> tuple[int, bytes]:
        """Read serial command from the input buffer.

        Raises:
            CommunicationTimeoutException if timeouts happen.

        Returns:
            tuple[int, bytes]:
                - Command id
                - Payload bytes
        """
        timeout_time = self._ser.timeout if self._ser.timeout is not None else 999
        timeout = serial.serialutil.Timeout(timeout_time)
        # read cmd and length bytes
        cmd_len = self._ser.read(2)
        if timeout.expired():
            raise CommunicationTimeoutError()
        cmd, length = cmd_len

        # read payload and crc using length
        payload_crc = self._ser.read(length + 2)
        if timeout.expired():
            raise CommunicationTimeoutError()
        payload = payload_crc[:-2]
        crc = payload_crc[-2:]

        # check crc
        cmd_len_and_payload = cmd_len + payload
        if crc != (crc_expected := calc_crc_ibm(cmd_len_and_payload).to_bytes(2, "big")):
            raise CRCError(
                f"Crc mismatch: {crc!r} instead of {crc_expected!r}. "
                f"Data: {cmd!r} {length!r} {payload!r}"
            )

        return cmd, payload

    def write_cmd(self, cmd: int, payload: bytes) -> None:
        """Send serial command.

        Args:
            cmd: command identifier
            payload: command payload.
        """
        length = len(payload)

        if length >= 256:
            raise ValueError("length does not fit in protocol")
        if cmd >= 255:
            raise ValueError("cmd is too high in value")

        cmd_len_payload = bytes((cmd, length)) + payload
        crc = calc_crc_ibm(cmd_len_payload).to_bytes(2, "big")
        self._ser.write(cmd_len_payload + crc)

    @override
    def reset_input_buffer(self) -> None:
        self._ser.reset_input_buffer()


DataType: TypeAlias = Literal[
    "uint8", "int8", "uint16", "int16", "uint32", "int32", "uint64", "int64", "float32", "float64"
]


_TYPE_DICT = {
    "uint8": ("<B", int, "uint8_t", 1, np.uint8),
    "int8": ("<b", int, "int8_t", 1, np.int8),
    "uint16": ("<H", int, "uint16_t", 2, np.uint16),
    "int16": ("<h", int, "int16_t", 2, np.int16),
    "uint32": ("<I", int, "uint32_t", 2, np.uint32),
    "int32": ("<i", int, "int32_t", 2, np.int32),
    "uint64": ("<L", int, "uint64_t", 2, np.uint64),
    "int64": ("<l", int, "int64_t", 2, np.int64),
    "float32": ("<f", float, "float", 4, np.float32),
    "float64": ("<d", float, "double", 8, np.float64),
}

T = TypeVar("T")


class Field(abc.ABC, Generic[T]):
    """Message field base class."""

    dtype: DataType
    """Underlying data type as string."""
    desc: Optional[str]
    """Description string of the field."""
    struct_char: str
    """Byte structure char sequence."""
    byte_size: int
    """Total size of this field in bytes."""
    python_type: type[T]
    """Type of field in Python after parsing."""

    def __init__(
        self,
        dtype: DataType,
        desc: Optional[str],
        byte_size: int,
        python_type: type[T],
    ) -> None:
        self.dtype = dtype
        self.desc = desc
        self.struct_char = f"{byte_size}s"
        self.byte_size = byte_size
        self.python_type = python_type

    @abc.abstractmethod
    def c_definition(self, name: str) -> str:
        """Get definition in the C programming language."""

    @abc.abstractmethod
    def parse(self, value: bytes) -> T:
        """Parse value from bytes to python type."""

    @abc.abstractmethod
    def format(self, value: Any) -> bytes:
        """Format value from python type to bytes."""


class NumberField(Field[T]):
    """Message field for base datatypes."""

    def __init__(self, dtype: DataType, desc: Optional[str] = None) -> None:
        (self._struct_char, python_type, self.c_type, byte_size, self._numpy_dtype) = _TYPE_DICT[
            dtype
        ]
        super().__init__(dtype, desc, byte_size, python_type)

    @override
    def c_definition(self, name: str) -> str:
        c_code = f"{self.c_type} {name};"
        if self.desc is not None:
            c_code += f" // {self.desc}"
        c_code += "\n"
        return c_code

    @override
    def parse(self, value: bytes) -> T:
        values = struct.unpack(self._struct_char, value)
        return self.python_type(*values)

    @override
    def format(self, value: T) -> bytes:
        return struct.pack(self._struct_char, value)


EnumT = TypeVar("EnumT", bound=enum.Enum)


class EnumField(Field, Generic[EnumT]):
    """Message field for enums."""

    def __init__(
        self, enum_type: type[EnumT], dtype: DataType = "uint8", desc: Optional[str] = None
    ) -> None:
        self._enum_type = enum_type
        (self._struct_char, python_type, self.c_type, byte_size, self._numpy_dtype) = _TYPE_DICT[
            dtype
        ]
        super().__init__(dtype, desc, byte_size, python_type)

    @override
    def parse(self, value: bytes) -> EnumT:
        values = struct.unpack(self._struct_char, value)
        try:
            return self._enum_type(*values)
        except ValueError as e:
            msg = f"Failed to parse enum {self._enum_type} with number {values[0]}"
            raise ValueError(msg) from e

    @override
    def format(self, value) -> bytes:
        if not isinstance(value, self._enum_type):
            msg = f"{value} is not {self._enum_type}"
            raise ValueError(msg)
        return struct.pack(self._struct_char, value.value)

    @override
    def c_definition(self, name: str) -> str:
        c_code = f"{self._enum_type.__name__} {name};"
        if self.desc is not None:
            c_code += f" // {self.desc}"
        c_code += "\n"
        return c_code

    def generate_c_code(self, enum_args: str, indent: int) -> str:
        """Create c code of message struct definition."""
        _ = enum_args
        c_code = f"typedef enum {self._enum_type.__name__} : {self.c_type} {{\n"
        for k in self._enum_type:
            c_code += " " * indent + f"{k.name} = {k.value},\n"
        c_code += f"}} {self._enum_type.__name__};"
        return c_code


class StructField(Field):
    """Message field for custom datatypes."""

    def __init__(self, struct_type: type["Message"], desc: Optional[str] = None) -> None:
        super().__init__("uint8", desc, struct_type.byte_size, struct_type)
        self.struct_type = struct_type
        self.c_type = struct_type.__name__
        self.byte_size = struct_type.byte_size

    @override
    def parse(self, value: bytes) -> "Message":
        return self.struct_type.from_bytes(value)

    @override
    def format(self, value: "Message") -> bytes:
        if not isinstance(value, self.python_type):
            msg = f"{value} is not of type {self.dtype}"
            raise ValueError(msg)
        ret: bytes = value.to_bytes()
        return ret

    @override
    def c_definition(self, name: str) -> str:
        c_code = f"{self.c_type} {name};"
        if self.desc is not None:
            c_code += f" // {self.desc}"
        c_code += "\n"
        return c_code


class ArrayField(Field):
    """Message field for multidimensional arrays of base datatypes."""

    def __init__(self, dtype: DataType, shape: Sequence[int], desc: Optional[str] = None) -> None:
        (_, python_type, self.c_type, byte_size, self._numpy_dtype) = _TYPE_DICT[dtype]
        byte_size = byte_size * np.prod(shape).item()
        self.shape = shape
        super().__init__(dtype, desc, byte_size, python_type)

    @override
    def c_definition(self, name: str) -> str:
        shape = "".join(f"[{x}]" for x in self.shape)
        c_code = f"{self.c_type} {name}{shape};"
        if self.desc is not None:
            c_code += f" // {self.desc}"
        c_code += "\n"
        return c_code

    @override
    def parse(self, value: bytes) -> np.ndarray:
        return np.frombuffer(value, dtype=self._numpy_dtype).reshape(self.shape)

    @override
    def format(self, value: np.ndarray) -> bytes:
        return np.asarray(value, dtype=self._numpy_dtype).tobytes()


class Message:
    byte_size: int
    _data_format: str
    _fields: dict[str, Field]
    _slices: tuple[slice]

    @classmethod
    def from_bytes(cls, payload: bytes) -> Self:
        """Decode message from bytes."""
        args = [
            f.parse(payload[slc]) for f, slc in zip(cls._fields.values(), cls._slices, strict=True)
        ]
        return cls(*args)

    def to_bytes(self) -> bytes:
        """Encode Message to bytes."""
        values = [
            f.format(v) for f, v in zip(self._fields.values(), self.__dict__.values(), strict=True)
        ]
        return b"".join(values)

    @classmethod
    def print_help(cls) -> None:
        """Print field types of this message."""
        print(cls.__name__)
        for k, v in cls._fields.items():
            print(f"- {k}: {v.dtype}")

    @classmethod
    def generate_c_code(cls, struct_args: str, indent: int) -> str:
        """Create c code of message struct definition."""
        c_code = f"typedef struct {struct_args} {{\n"
        for k, v in cls._fields.items():
            c_code += " " * indent + v.c_definition(k)
        c_code += f"}} {cls.__name__};"
        return c_code


ArrayT = TypeVar("ArrayT", np.ndarray, int, str, list, tuple, float)


def array_safe_eq(a: ArrayT, b: ArrayT) -> bool:
    """Check if a and b are equal, even if they are numpy arrays."""
    if a is b:
        return True
    if isinstance(a, np.ndarray) and isinstance(b, np.ndarray):
        return a.shape == b.shape and (a == b).all()
    return a == b


def dataclass_eq(dc1: Any, dc2: Any) -> bool:
    """Check if two dataclasses which hold numpy arrays are equal."""
    if dc1 is dc2:
        return True
    if dc1.__class__ is not dc2.__class__:
        return False
    t1 = dataclasses.astuple(dc1)
    t2 = dataclasses.astuple(dc2)
    return all(array_safe_eq(a1, a2) for a1, a2 in zip(t1, t2))


ClassT = TypeVar("ClassT", type, type)


def make_message(cls: ClassT) -> ClassT:
    """Compose a message dataclass."""
    fields: dict[str, Field] = {
        attr_name: attr
        for attr_name, attr in cls.__dict__.items()
        if not attr_name.startswith("_") and isinstance(attr, Field)
    }

    data_format = "<" + "".join([f.struct_char for f in fields.values()])
    byte_size = sum([v.byte_size for v in fields.values()])

    dataclass_fields = [(name, f.python_type, dataclasses.field()) for name, f in fields.items()]

    pos = 0
    slices = []
    for f in fields.values():
        length = f.byte_size
        slices.append(slice(pos, pos + length))
        pos += length

    return dataclasses.make_dataclass(
        cls.__name__,
        dataclass_fields,
        namespace={
            "byte_size": byte_size,
            "_data_format": data_format,
            "_fields": fields,
            "_slices": slices,
            "__eq__": dataclass_eq,
            "__name__": cls.__name__,
        },
        bases=(Message,),
        eq=False,
    )


def gen_code_with_dependencies(
    messages: Sequence[type[Message]],
    h_file: Union[pathlib.Path, str],
    indent: int = 4,
    *,
    skip_file_write: bool = False,
    include_dependencies: bool = True,
) -> str:
    """Export a .h file of the message definitions."""
    h_file = pathlib.Path(h_file)

    dependencies: list[type[Message] | EnumField] = list(messages)

    def check_msg(msg: type[Message]):
        for v in msg._fields.values():
            if not isinstance(v.dtype, str):
                dependencies.append(v.dtype)
                check_msg(v.dtype)
            elif isinstance(v, EnumField):
                dependencies.append(v)
            elif isinstance(v, StructField):
                dependencies.append(v.struct_type)

    if include_dependencies:
        for m in messages:
            check_msg(m)

    deps = list(dict.fromkeys(reversed(dependencies)))

    struct_args = "__attribute__((__packed__))"

    code_list = [d.generate_c_code(struct_args, indent) for d in deps]
    code_str = "\n\n".join(code_list)

    name = h_file.stem.upper()

    all_code = (
        "//Autogenerated code\n\n"
        f"#ifndef {name}_H_\n"
        f"#define {name}_H_\n"
        "\n"
        "#ifdef __cplusplus\n"
        'extern "C" {\n'
        "#endif\n"
        "\n"
        "#include <stdint.h>\n"
        "\n"
        f"{code_str}"
        "\n\n"
        "#ifdef __cplusplus\n"
        "}\n"
        "#endif\n"
        "\n"
        f"#endif /* {name}_H_ */\n"
    )

    if not skip_file_write:
        with h_file.open("w") as f:
            f.write(all_code)

    return all_code


InMessageT = TypeVar("InMessageT", bound=Message)
OutMessageT = TypeVar("OutMessageT", bound=Message)


class Command(abc.ABC, Generic[InMessageT, OutMessageT]):
    """Base class for communication commands."""

    cmd: int
    request_type: type[InMessageT]
    response_type: type[OutMessageT]

    @abc.abstractmethod
    def execute(self, payload: InMessageT) -> OutMessageT:
        """Execute command.

        Override this method to implement the command logic.
        """

    @classmethod
    def generate_c_code(cls):
        """Create c code of command struct definition."""
        c_code = f"{cls.response_type.__name__}* {cls.__name__}({cls.request_type.__name__});"
        c_code += f" // cmd_id: {cls.cmd}\n"
        return c_code


class CommandHandler:
    """Execute received commands."""

    def __init__(
        self,
        serial: PacketHandler,
        commands: Sequence[Command],
        default_message: Message,
    ):
        self.serial = serial
        self._logger = logging.getLogger("CommandHandler")
        assert len({c.cmd for c in commands}) == len(commands), "Commands are not unique."
        self._commands = {c.cmd: c for c in commands}
        self._default_message = default_message

    def run_indefinitely(self):
        """Handle incoming commands indefinitely."""
        while True:
            with contextlib.suppress(CommunicationTimeoutError):
                cmd_id, payload = self.serial.read_cmd()
                command: Command | None = self._commands.get(cmd_id)
                if command is None:
                    self.serial.write_cmd(cmd_id, self._default_message.to_bytes())
                else:
                    request_type: type[Message] = command.request_type
                    request = request_type.from_bytes(payload)
                    self._logger.info(f"RX: {request.__class__.__name__}")
                    response: Message = command.execute(request)
                    self.serial.write_cmd(cmd_id, response.to_bytes())
