ntobler/startracker/startracker/initial_starcal.py

"""Create a camera calibration from stars observations only."""

import dataclasses
import time
from typing import Optional

import numpy as np
import numpy.typing as npt
import ruststartracker
import scipy.spatial

from startracker import (
    attitude_estimation,
    const,
    kalkam,
    libstartracker,
    starcamcal,
)


class MovementRegisterer:
    """Get star movement from a sequence of star images."""

    class Candidate:
        """Data structure representing a moving star candidate."""

        positions: list[np.ndarray]
        thresholds: list[float]
        times: list[float]
        undetected_spree: int

        def __init__(self, position: np.ndarray, t: float):
            self.positions = [position]
            self.thresholds = [3]
            self.times = [t]
            self.undetected_spree = 0

    PERSIST_THRESHOLD = 10
    MAX_F64 = np.finfo(np.float64).max

    candidates: list[Candidate] = []

    def __init__(self):
        self.candidates = []

    def reset(self):
        """Reset tracked stars."""
        self.candidates = []

    def __call__(self, centroids: np.ndarray, t: float) -> None:
        """Add star position to be registered.

        Args:
            centroids: Image positions of stars. shape=[n, 2]
            t: time in seconds. First call has time=0
        """
        most_recent_positions = np.array(
            [c.positions[-1] for c in self.candidates], dtype=np.float64
        ).reshape((-1, 2))

        distance_thesholds = np.array([c.thresholds[-1] for c in self.candidates])

        unmatched_existing = np.ones(len(self.candidates))
        unmatched_new = np.ones(len(centroids))

        distances = np.linalg.norm(centroids[:, None] - most_recent_positions[None, :], axis=-1)
        for _ in range(np.min(distances.shape)):
            new_index, existing_index = np.unravel_index(np.argmin(distances), distances.shape)
            distance = distances[new_index, existing_index]

            threshold = distance_thesholds[existing_index]
            if distance < threshold:
                # match found

                c = self.candidates[existing_index]
                c.positions.append(centroids[new_index].copy())
                c.thresholds.append(threshold)
                c.times.append(t)

                distances[new_index, :] = self.MAX_F64
                distances[:, existing_index] = self.MAX_F64
                unmatched_new[new_index] = False
                unmatched_existing[existing_index] = False

            else:
                # No more matches found
                break

        for existing_index in np.where(unmatched_existing)[0]:
            c = self.candidates[int(existing_index)]
            c.undetected_spree += 1

        self.candidates = [
            c for c in self.candidates if c.undetected_spree < self.PERSIST_THRESHOLD
        ]

        for new_index in np.where(unmatched_new)[0]:
            c = MovementRegisterer.Candidate(centroids[new_index].copy(), t)
            self.candidates.append(c)

    def get_results(
        self,
        *,
        sample_percentile: int = 50,
        fit_mse_threshold: float = 0.1,
        min_observations_per_trail: int = 8,
        return_best_percentile: int = 50,
        plot: bool = False,
    ) -> tuple[np.ndarray, np.ndarray, np.ndarray]:
        """Get Positions of stars and their movement direction.

        Args:
            sample_percentile: Percentile of samples in a trail used for the polynomial fit
            fit_mse_threshold: Mean squared error threshold for polynomial fit to star trails.
            min_observations_per_trail: Minimum number of observations in a star trail for it to be
                considered.
            return_best_percentile: Return a percentile of best fitted stars.
            plot: Plot results with matplotlib.

        Returns:
            star image positions shape=[n, 2],
            star movement vector in pixels per second, shape=[n, 2],
            mean squared error of the star trail polynomial fit
        """
        good_candidates = [
            c for c in self.candidates if len(c.positions) >= min_observations_per_trail
        ]

        if plot and good_candidates:
            import matplotlib.pyplot as plt

            fig, ax = plt.subplots()
            ax.set_aspect(1)

        stars_xy_list = []
        stars_dxy_list = []
        mses_list = []

        for c in good_candidates:
            t = np.array(c.times, np.float64)
            t -= np.mean(t)
            positions = np.array(c.positions)

            # Fit curve and discard 20% of the points that don't match
            p, sse, _, _, _ = np.polyfit(t, positions, 2, full=True)
            fit_positions = np.array([np.polyval(pp, t) for pp in p.T]).T
            errors = np.abs(np.linalg.norm(positions - fit_positions, axis=-1))
            mask = errors < np.percentile(errors, sample_percentile)
            positions = positions[mask]
            t = t[mask]

            # Fit curve again using 80 % of samples
            p, sse, _, _, _ = np.polyfit(t, positions, 2, full=True)
            mse = sse / len(t)

            # Discard fits with high error
            if mse.size == 0 or np.any(mse > fit_mse_threshold):
                continue

            xy = [np.polyval(pp, 0) for pp in p.T]
            dx_dy = [np.polyval(pp[:-1], 0) for pp in p.T]

            if plot:
                t_poly = np.linspace(t.min(), t.max(), 20)
                positions_poly = [np.polyval(pp, t_poly) for pp in p.T]

                x, y = positions.T
                a = ax.plot(x, y, ".-", color="red")

                x, y = positions_poly
                ax.plot(x, y, "-", color=a[0].get_color())

                x, y = xy
                dx, dy = np.array(dx_dy) * t.max()
                ax.arrow(x, y, dx, dy, color="black", lw=2)  # type: ignore[arg-type]

            stars_xy_list.append(xy)
            stars_dxy_list.append(dx_dy)
            mses_list.append(mse)

        if plot and good_candidates:
            plt.show()

        stars_xy = np.array(stars_xy_list, dtype=np.float64)
        stars_dxy = np.array(stars_dxy_list, dtype=np.float64)
        mses = np.array(mses_list, dtype=np.float64)

        if return_best_percentile < 100:
            combined_mses = np.linalg.norm(mses, axis=-1)
            mask = combined_mses < np.percentile(combined_mses, return_best_percentile)
            stars_xy = stars_xy[mask]
            stars_dxy = stars_dxy[mask]
            mses = mses[mask]

        return stars_xy, stars_dxy, mses


class StarGradientCalibrationError(Exception):
    pass


def star_gradient_calibration(
    stars_xy_np: np.ndarray,
    stars_dxy_np: np.ndarray,
    width: int,
    height: int,
    intrinsic0: Optional[np.ndarray] = None,
    theta0: Optional[float] = None,
    epsilon0: Optional[float] = None,
    *,
    tol: float = 1e-4,
    max_iter: int = 20,
    verbose: bool = False,
    plot: bool = False,
) -> tuple[np.ndarray, float, float, float, float]:
    """Estimate intrinsic and partial extrinsic from star image positions and their movement.

    Args:
        stars_xy_np: Image coordinates of observed stars.
        stars_dxy_np: Temporal gradient of image coordinates of observed stars (per second).
        width: Image width in pixels.
        height: Image height in pixels.
        intrinsic0: Optional initial intrinsic matrix
        theta0: Optional declination angle in rads
        epsilon0: Optional roll angle of the camera about its axis in rads.
        tol: Tolerance for Levenberg-Marquardt algorithm.
        max_iter: Maximum number of iterations in Levenberg-Marquardt algorithm.
        verbose: Print messages
        plot: Plot using matplotlib

    Returns:
        - Intrinsic camera matrix estimate,
        - First OpenCV distortion coefficient (r^2)
        - Theta, declination angle in rads in the equatorial coordinate system
            (North pole: pi/2, South pole: -pi/2)
        - Epsilon, roll angle of the camera about it's axis
        - Estimation error
    """
    if intrinsic0 is None:
        fxy = np.maximum(width, height)
        intrinsic0s_list = [
            np.array(
                (
                    (f, 0, width / 2),
                    (0, f, height / 2),
                    (0, 0, 1),
                ),
                dtype=np.float64,
            )
            for f in np.logspace(np.log10(0.5), np.log10(4), 4) * fxy
        ]
        intrinsic0s = np.stack(intrinsic0s_list, axis=0)
    else:
        intrinsic0s = np.array(intrinsic0, dtype=np.float64, copy=False)[np.newaxis]

    theta0s = (
        np.linspace(-0.5, 0.5, 8, dtype=np.float64) * np.pi
        if theta0 is None
        else np.array([theta0], dtype=np.float64)
    )
    epsilon0s = (
        np.linspace(-1 + 0.125, 1 - 0.125, 4, dtype=np.float64) * np.pi
        if epsilon0 is None
        else np.array([epsilon0], dtype=np.float64)
    )

    # Build combinations of theta and epsilon starting conditions
    theta0s, epsilon0s, intrinsic_indices = np.meshgrid(
        theta0s, epsilon0s, np.arange(len(intrinsic0s))
    )
    theta0s = theta0s.ravel()
    epsilon0s = epsilon0s.ravel()
    intrinsic0s = intrinsic0s[intrinsic_indices.ravel()]

    if verbose:
        print(f"Finding best initial states with {len(stars_xy_np)} stars")

    stars_xy_f32 = np.array(stars_xy_np, dtype=np.float32, copy=False)
    stars_dxy_f32 = np.array(
        stars_dxy_np / const.EARTH_ANGULAR_VELOCITY, dtype=np.float32, copy=False
    )

    # Try the grid of initial conditions to find a low basin
    prior_errors_list = []
    for theta0, epsilon0, intrinsic0 in zip(theta0s, epsilon0s, intrinsic0s, strict=True):
        residuals, _ = libstartracker.stargradcal_objective_function(
            stars_xy_f32, stars_dxy_f32, intrinsic0, 0.0, float(theta0), float(epsilon0)
        )
        prior_errors_list.append(np.sum(residuals**2))
    best_indices = np.argsort(prior_errors_list)[:4]

    if verbose:
        print("Starting optimization (preselection)")

    # Solve selected indices with a few iterations
    results = []
    errors = []
    for i in best_indices:
        theta0 = float(theta0s[i])
        epsilon0 = float(epsilon0s[i])
        intrinsic0 = intrinsic0s[i]
        res = libstartracker.stargradcal_calibrate(
            stars_xy_f32, stars_dxy_f32, intrinsic0, 0.0, theta0, epsilon0, tol, max_iter=10
        )
        results.append(res)
        errors.append(np.sum(res[-1] ** 2))

    # Get best initial values
    i = best_indices[np.argmin(errors)]
    theta0 = float(theta0s[i])
    epsilon0 = float(epsilon0s[i])
    intrinsic0 = intrinsic0s[i]

    if verbose:
        print("Starting optimization (final)")

    # Perform the ultimate optimization
    res = libstartracker.stargradcal_calibrate(
        stars_xy_f32, stars_dxy_f32, intrinsic0, 0.0, theta0, epsilon0, tol, max_iter
    )
    intrinsic, dist_coef, theta, epsilon, residuals = res
    intrinsic = np.copy(intrinsic.T)
    residuals = residuals.reshape((len(stars_dxy_np)), 2) * const.EARTH_ANGULAR_VELOCITY
    error = (
        (np.linalg.norm(residuals, axis=-1) / np.linalg.norm(stars_dxy_np, axis=-1)).mean().item()
    )

    # Check if the intrinsic is valid
    if intrinsic[0, 0] < 0 or intrinsic[1, 1] < 0:
        raise StarGradientCalibrationError(
            "Calibration resulted in invalid negative focal lengths."
        )

    if plot:
        import matplotlib.pyplot as plt

        _, ax = plt.subplots(1)
        ax.quiver(
            stars_xy_np[..., 0],  # x positions
            stars_xy_np[..., 1],  # y positions
            stars_dxy_np[..., 0],  # dx
            stars_dxy_np[..., 1],  # dy
            angles="xy",
            scale_units="xy",
            scale=100,
            color="black",
            width=0.002,
        )
        ax.quiver(
            stars_xy_np[..., 0],  # x positions
            stars_xy_np[..., 1],  # y positions
            stars_dxy_np[..., 0] + residuals[..., 0],  # dx
            stars_dxy_np[..., 1] + residuals[..., 1],  # dy
            angles="xy",
            scale_units="xy",
            scale=100,
            color="red",
            width=0.002,
        )
        plt.show()

    # Wrap angles
    epsilon = ((epsilon + np.pi) % (2 * np.pi)) - np.pi
    theta = ((theta + np.pi) % (2 * np.pi)) - np.pi

    return (intrinsic, dist_coef, theta, epsilon, error)


@dataclasses.dataclass
class StarCalibratorConfig:
    attitude_estimator_config: attitude_estimation.AttitudeEstimatorConfig
    """Initial configuration of the attitude estimator."""
    min_time_delta: float = 9
    """Minimum difference of capture times between two images."""

    movement_register_mse_threshold: float = 1.0
    """Maximum allowed mean squared error for the star movement regression."""
    movement_register_min_points: int = 20
    """Minimum amount of star movement points required to proceed with the calibration."""
    max_initial_calibration_error: float = 1.0
    """Maximum allowed error the the initial camaera calibration using star movement."""

    recalibration_percentile: float = 99.0
    """Percentile of data used for second calibration."""
    interval: int = 5
    """Skip calibrations for given number of received samples"""

    min_calibration_points: int = 20
    """Minimum number of points required for a fine calibration. The problem has 12 DoF."""
    max_rms_pixel_error: float = 2.0
    """Maximum pixel RMS error for a fine calibration to be accepted."""


class StarCalibrator:
    """Calibrate a camera from footage stream of stars.

    The camera has to be stationary and aimed at the night sky. Ideally pointed to an equatorial
    region, as the algorithm favors fast moving stars.
    """

    image_size: tuple[int, int]

    star_match_fraction: list[float]
    """Fraction of observations that match stars in the catalog."""
    rms_errors: list[float]
    """Root mean squared errors of the full calibration"""
    max_errors: list[float]
    """Max errors of the full calibration"""
    median_errors: list[float]
    """Max errors of the full calibration"""
    times: list[float]
    """Times of given star capture samples."""

    extrinsics: list[np.ndarray]
    intrinsics: list[np.ndarray]
    dist_coeffs: list[np.ndarray]

    observed_stars_xy: list[np.ndarray]
    """List of image positions of observed star candidates."""
    image_xy_list: list[np.ndarray]
    """List of image positions of matched stars."""

    first_estimate_acquired: bool

    def __init__(self, config: StarCalibratorConfig, image_size: tuple[int, int]) -> None:
        self._config = config
        self.image_size = image_size

        self.times = []
        self.star_match_fraction = []
        self.rms_errors = []
        self.max_errors = []
        self.median_errors = []
        self.extrinsics = []
        self.intrinsics = []
        self.dist_coeffs = []

        self.observed_stars_xy = []

        # These values will be recalculated if the calibration changes
        self.image_xy_list = []
        self._cat_xyz_list: list[np.ndarray] = []
        self._match_fractions: list[float] = []
        self._quat_list: list[np.ndarray] = []

        # Initialize with dummy values
        cal = kalkam.IntrinsicCalibration(np.eye(3), np.zeros(5), image_size)
        self.ae = attitude_estimation.AttitudeEstimator(
            cal, config=config.attitude_estimator_config
        )

        # Initialize movement Registerer for initial ultra coarse calibration
        self.movement_registerer = MovementRegisterer()

        self.first_estimate_acquired = False
        self.starbased_calibration_acquired = False

    def put_image(self, image: npt.NDArray[np.uint8], t: float) -> None:
        """Add an image to the calibration."""
        # Only accept samples if enough time has passed between observations
        if self.times and t < self.times[-1] + self._config.min_time_delta:
            # Not enough time passed for a new sample
            return

        try:
            stars_xy = self.ae.get_star_positions(image)
        except ruststartracker.StarTrackerError:
            # No stars found in image
            return

        self.observed_stars_xy.append(stars_xy)
        self.times.append(t)
        self.star_match_fraction.append(
            0 if not self.star_match_fraction else self.star_match_fraction[-1]
        )
        self.rms_errors.append(np.nan if not self.rms_errors else self.rms_errors[-1])
        self.max_errors.append(np.nan if not self.max_errors else self.max_errors[-1])
        self.median_errors.append(np.nan if not self.median_errors else self.median_errors[-1])
        self.extrinsics.append(
            np.array(((1, 0, 0, 0), (0, 1, 0, 0), (0, 0, 1, 0)), dtype=np.float64)
            if not self.extrinsics
            else self.extrinsics[-1].copy()
        )
        self.intrinsics.append(
            np.full((3, 3), np.nan) if not self.intrinsics else self.intrinsics[-1].copy()
        )
        self.dist_coeffs.append(
            np.full((5,), np.nan) if not self.dist_coeffs else self.dist_coeffs[-1].copy()
        )

        # Track movement for star gradient calibration
        if not self.starbased_calibration_acquired:
            self.movement_registerer(stars_xy, t)

        # Only continue in regular intervals
        if len(self.times) % self._config.interval != 0:
            return

        if not self.starbased_calibration_acquired:
            # Initially, a basic calibration is needed to feed the star-based attitude estimator
            # with calibration parameters. These parameters are estimated from the movement of stars
            # across the sky.

            # Get star positions and their gradient in image coordinates.
            stars_xy, stars_dxy, mses = self.movement_registerer.get_results()

            # Check if there is enough points with good quality fits
            if (
                np.count_nonzero(mses < self._config.movement_register_mse_threshold)
                < self._config.movement_register_min_points
            ):
                return

            # Fit calibration to star movement
            height, width = image.shape
            try:
                intrinsic, dist_coef, theta, epsilon, error = star_gradient_calibration(
                    stars_xy, stars_dxy, width, height, tol=1e-6, max_iter=20
                )
            except StarGradientCalibrationError:
                # This calibration can sometimes fail
                return

            r = scipy.spatial.transform.Rotation.from_euler(
                "zxz", (epsilon, np.pi / 2 - theta, 0), degrees=False
            )

            # Store parameters
            self.extrinsics[-1][:3, :3] = r.as_matrix().T
            self.intrinsics[-1][:] = intrinsic
            self.dist_coeffs[-1][0] = dist_coef
            self.dist_coeffs[-1][1:] = 0.0

            # If the calibration was bad, do it over next time
            if error > self._config.max_initial_calibration_error:
                return

            # Mark initial calibration as successful
            self.first_estimate_acquired = True

            cal = kalkam.IntrinsicCalibration(
                intrinsic=intrinsic,
                dist_coeffs=np.array([dist_coef, 0, 0, 0, 0]),
                image_size=(width, height),
            )

            # Set a filter for the attitude estimator to reduce the number of potential stars
            # Since the declination angle is known, the star catalog can be reduced to a band around
            # the night sky
            angle_margin_factor = 1.5  # Generic enough to be hardcoded
            half_fov_rad = angle_margin_factor * np.arctan(
                np.hypot(width, height) / intrinsic[0, 0] / 2
            )

            def filt(cat_xyz: np.ndarray, mag: np.ndarray) -> np.ndarray:
                # Only consider stars in a latitudinal band around the theta angle
                cat_theta = np.arcsin(cat_xyz[..., 2])
                mask: npt.NDArray[np.bool_] = np.abs(cat_theta - theta) < half_fov_rad
                # Only consider bright stars
                mask *= mag < 6.0
                return mask

            # Calibration needs to be set before filter,
            # As initialization fails with a dummy camera calibration
            self.ae.update(cal=cal, cat_filter=filt)

        if self.first_estimate_acquired:
            # Estimate rotations
            already_calculated = len(self._match_fractions)
            for xy, t in zip(
                self.observed_stars_xy[already_calculated:],
                self.times[already_calculated:],
                strict=True,
            ):
                result = self.ae.estimate_from_image_positions(xy)

                self._match_fractions.append(result.n_matches / len(xy))

                if result.n_matches == 0:
                    continue

                # Use image/object points pairs for calibration
                matched_img_xy = xy[result.obs_indices]
                self.image_xy_list.append(matched_img_xy)
                rads = -t * const.EARTH_ANGULAR_VELOCITY
                # Rotate the object points around the Earth's axis to compensate for the
                # time shift
                rot_correction = scipy.spatial.transform.Rotation.from_rotvec(
                    [0, 0, rads], degrees=False
                )
                r = scipy.spatial.transform.Rotation.from_quat(result.quat)
                self._quat_list.append((rot_correction * r).as_quat())
                time_corrected_cat_xyz = rot_correction.apply(result.cat_xyz)
                self._cat_xyz_list.append(time_corrected_cat_xyz)

            mean_match_fraction = np.mean(self._match_fractions).item()

            self.star_match_fraction[-1] = mean_match_fraction

            if len(self.image_xy_list) == 0:
                return

            # Filter outliers
            # Some attitude estimation results might be wrong, even though they are successful.
            # By checking the sum of rotational distances from each quaternion, it is possible
            # to track down outliers
            # TODO find a way to more efficiently discard outliers
            rots = scipy.spatial.transform.Rotation.from_quat(self._quat_list)
            mag_sums = [np.sum((rots * r.inv()).magnitude()) for r in rots]  # type: ignore[attr-defined]
            r = rots[np.argmin(mag_sums)]
            mags = (rots * r.inv()).magnitude()
            best_indices = np.nonzero(mags < np.radians(2))[0]

            # Concatenate all valid image observations and their catalog positions
            cat_xyz = np.concatenate(
                [self._cat_xyz_list[i] for i in best_indices], axis=0, dtype=np.float32
            )
            image_xy = np.concatenate(
                [self.image_xy_list[i] for i in best_indices], axis=0, dtype=np.float32
            )

            # Rotate catalog coordinates such they result in smaller rotation values in the
            # calibration problem
            cat_xyz_camera = r.inv().apply(cat_xyz).astype(np.float32)

            if False:
                import matplotlib.pyplot as plt

                print("Plotting...")
                fig, axs = plt.subplots(2)
                s = np.concatenate(self.observed_stars_xy, axis=0)
                axs[0].plot(s[..., 0], s[..., 1], ".", alpha=0.2)
                axs[0].plot(image_xy[..., 0], image_xy[..., 1], "x")
                axs[0].set_aspect("equal")
                axs[0].invert_yaxis()
                axs[0].set_title("Image points")
                axs[1].plot(cat_xyz_camera[..., 0], cat_xyz_camera[..., 1], "x")
                axs[1].set_aspect("equal")
                axs[1].invert_yaxis()
                axs[1].set_title("Object points (x and y axis)")
                plt.show()

            # Don't attempt calibration with very few samples
            if len(cat_xyz_camera) < self._config.min_calibration_points:
                return

            # Calibrate camera
            height, width = image.shape
            intrinsic, dist_coeffs, _, reprojection = starcamcal.calibrate_camera(
                cat_xyz_camera,
                image_xy,
                (width, height),
                intrinsic_guess=self.ae.cal.intrinsic,
            )

            # Performing second calibration iteration with percentile of best samples
            if self._config.recalibration_percentile < 100:
                squared_error_distances = np.square(image_xy - reprojection).sum(axis=-1)
                threshold = np.percentile(
                    squared_error_distances, self._config.recalibration_percentile
                )
                mask = squared_error_distances < threshold
                cat_xyz_camera = cat_xyz_camera[mask]
                image_xy = image_xy[mask]

                # Calibrate camera with filtered set
                intrinsic, dist_coeffs, _, reprojection = starcamcal.calibrate_camera(
                    cat_xyz_camera,
                    image_xy,
                    (width, height),
                    intrinsic_guess=intrinsic,
                    dist_coefs_guess=dist_coeffs,
                )

            # Build camera calibration parameters
            squared_error_distances = np.square(image_xy - reprojection).sum(axis=-1)
            rms_error = float(np.sqrt(squared_error_distances.mean()))
            max_error = float(np.sqrt(squared_error_distances.max()))
            median_error = float(np.sqrt(np.median(squared_error_distances)))
            timestamp = int(time.time() * 1000)
            cal = kalkam.IntrinsicCalibrationWithData(
                intrinsic,
                dist_coeffs,
                self.ae.cal.image_size,
                rms_error,
                max_error,
                timestamp,
                [image_xy],
                [squared_error_distances],
            )

            # Don't use parameters if the error is very large
            if rms_error > self._config.max_rms_pixel_error:
                return

            self.starbased_calibration_acquired = True

            # Store parameters
            self.rms_errors[-1] = float(rms_error)
            self.max_errors[-1] = float(max_error)
            self.median_errors[-1] = float(median_error)
            self.extrinsics[-1][:3, :3] = r.inv().as_matrix()
            self.intrinsics[-1][:] = intrinsic
            self.dist_coeffs[-1][:] = dist_coeffs

            # Use new calibration if it is better than the last one
            if (
                isinstance(self.ae.cal, kalkam.IntrinsicCalibrationWithData)
                and cal.rms_error < self.ae.cal.rms_error
            ) or not isinstance(self.ae.cal, kalkam.IntrinsicCalibrationWithData):
                # Update the star tolerance with the estimated maximum error
                ae_config = self.ae.config
                ae_config.star_match_pixel_tol = rms_error * 3.0

                # Set the updated calibration and remove the filter on the catalog
                self.ae.update(cal=cal, cat_filter=None, config=ae_config)

                # Reset calculated values, so they will be recalculated
                self.image_xy_list = []
                self._cat_xyz_list = []
                self._match_fractions = []
                self._quat_list = []

    def plot(self, gt_intrinsic: Optional[np.ndarray], gt_dist_coeffs: Optional[np.ndarray] = None):
        """Create plot with matplotlib."""
        import matplotlib.pyplot as plt

        fig, axs = plt.subplots(3, sharex=True)
        axs[0].semilogy(self.times, self.rms_errors, label="rms errors")
        axs[0].semilogy(self.times, self.max_errors, label="max errors")
        axs[0].semilogy(self.times, self.median_errors, label="median errors")
        axs[0].grid()
        axs[0].legend()

        axs[1].plot(self.times, self.star_match_fraction, label="Match fraction")
        axs[1].grid()
        axs[1].set_ylim(0, 1)
        axs[1].legend()

        intrinsic_params = {"fx": (0, 0), "fy": (1, 1), "tx": (0, 2), "ty": (1, 2)}
        axs[2].axhline(y=1, color="black")
        for label, (i, j) in intrinsic_params.items():
            base = self.intrinsics[-1][i, j] if gt_intrinsic is None else gt_intrinsic[i, j]
            y = np.array([x[i, j] for x in self.intrinsics])
            y /= base
            axs[2].plot(self.times, y, label=label)
        dist_params = {"k1": 0, "p1": 2, "p2": 3}
        for label, i in dist_params.items():
            base = self.dist_coeffs[-1][i] if gt_dist_coeffs is None else gt_dist_coeffs[i]
            y = np.array([x[i] for x in self.dist_coeffs])
            y /= base
            axs[2].plot(self.times, y, label=label)
        axs[2].legend()

        axs[0].set_xlim(0, self.times[-1])
        axs[1].set_xlim(0, self.times[-1])
        axs[2].set_xlim(0, self.times[-1])

        plt.show()
        plt.close(fig)
