ntobler/startracker/src/webutils.rs

use std::error::Error;
use std::fmt;
use std::sync::{Arc, Condvar, Mutex};
use std::time::Duration;

// Custom error for timeout
#[derive(Debug)]
pub struct TimeoutError;

impl fmt::Display for TimeoutError {
    fn fmt(&self, f: &mut fmt::Formatter) -> fmt::Result {
        write!(f, "Operation timed out")
    }
}

impl Error for TimeoutError {}

pub struct DataDispatcher<T> {
    data: Arc<Mutex<Option<T>>>,
    data_changed: Arc<Condvar>,
}

impl<T: Clone + Send + Sync + 'static> DataDispatcher<T> {
    pub fn new() -> Self {
        DataDispatcher {
            data: Arc::new(Mutex::new(None)),
            data_changed: Arc::new(Condvar::new()),
        }
    }

    pub fn put(&self, data: T) {
        let mut data_guard = self.data.lock().unwrap();
        *data_guard = Some(data);
        self.data_changed.notify_all();
    }

    pub fn get_blocking(&self) -> T {
        let mut data_guard = self.data.lock().unwrap();
        data_guard = self.data_changed.wait(data_guard).unwrap();
        data_guard.as_ref().unwrap().clone()
    }

    pub fn get_blocking_with_timeout(&self, timeout: Duration) -> Result<T, TimeoutError> {
        let mut data_guard = self.data.lock().unwrap();
        let (new_data_guard, wait_timeout_result) =
            self.data_changed.wait_timeout(data_guard, timeout).unwrap();
        data_guard = new_data_guard;

        if wait_timeout_result.timed_out() {
            return Err(TimeoutError);
        }

        Ok(data_guard.as_ref().unwrap().clone())
    }
}

impl<T> Clone for DataDispatcher<T> {
    fn clone(&self) -> Self {
        DataDispatcher {
            data: Arc::clone(&self.data),
            data_changed: Arc::clone(&self.data_changed),
        }
    }
}
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
