ntobler/startracker/(commit log)

2023-10-05 Added motor trajectory solvers
2023-10-15 created PCB project and modified .gitignore
    [Startracker_mainboard.PrjPcb, Startracker_mainboard.SchDoc]
2023-10-25 Fixed fermat_point for multiple batch dimensions
    [trajectory.py]
2023-10-25 added max stepper error plot
    [motor_alignment_evaluation.py]
2023-11-03 Added imx462 camera
2023-11-04 Created first schematic draft, microcontroller IO are yet to be defined
    [Startracker_Mainboard.SchDoc, Startracker_Power.SchDoc, Startracker_Stepper.SchDoc, Startracker_mainboard.PrjPcb, Startracker_mainboard.SchDoc]
2023-11-12 Added attitude estimation, fixed CalcTrajectory command
    [attitude_estimation.py, main.py, test_main.py, trajectory.py]
2023-11-12 Added github pipeline, pre-commit, fixed pre-commit errors
    [camera.py]
2023-11-12 fast task for motor control
2023-11-12 Schematic mostly done, MCU connections not final Routing begun and work in progress
    [Startracker_Mainboard.SchDoc, Startracker_Power.SchDoc, Startracker_Stepper.SchDoc, Startracker_mainboard.PrjPcb]
2023-11-12 pullup on i2c
2023-11-12 button long press
2023-11-13 Fixed enum declaration in code generation
    [communication.py]
2023-11-15 imu handling logic
2023-11-15 PCB ready for review
    [A00_Startracker.csv, StartrackerA00_BOM.xlsx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]
2023-11-24 power on fix and power bridging
    [application.cpp]
2023-11-24 button definitions
2023-11-24 display DMA speed up
2023-11-24 Renamed camera_webgui
2023-11-24 Added camera recorder utility script
2023-11-24 Added Camera calibration
2023-11-24 4 button navigation
2023-11-26 ADC and motor current PWM
2023-11-26 updated charging logic with filters
2023-11-26 battery level
2023-11-27 motor state maching
2023-11-27 ui states and button
2023-11-29 fine tuned stepper motor current and hold
2023-11-29 MPU interrupt mode (power saving)
2023-11-29 performance counter; i2c timeout
2023-11-29 make boost not crash entire system
    [motor.cpp]
2024-02-11 removed camera_debug
2024-02-11 renamed camera webgui
2024-02-11 Fixed get test context
    [testing_utils.py]
2024-02-11 Improved camera abstraction
2024-02-18 Added thread termination
2024-02-19 Updated camera webgui style
2024-02-19 fixed raspberrypi camera errors
    [camera_recorder.py, rpi.py]
2024-02-19 added debug camera
2024-02-19 changed camera webgui into class, added calibrate button
2024-02-20 Added startracker error handling
    [attitude_estimation.py, test_attitude_estimation.py, testing_utils.py]
2024-02-24 split webutil from camera_webgui
2024-02-24 added camera axis calibration
2024-02-24 fixed axis align camera frame
    [calibration.py]
2024-02-25 added continuous mode to camera, fixed binning
    [camera.py, rpi.py]
2024-05-01 fixed raspberrypi setup
2024-05-03 Switched to poetry, cleaned up install dir
2024-05-03 Fixed arccos out of domain
    [transform.py]
2024-05-09 Restructured calibration, added to camera webgui
2024-05-13 Slip draw grid into image utils, added distortion to PointProjector
    [image_utils.py, kalkam.py, testing_utils.py]
2024-05-13 Added star tracking to camera webgui
2024-05-13 added image size to intrinsic calibration
2024-05-13 Replaced camera calibration with kalkam instance
    [attitude_estimation.py, calibration.py, kalkam.py, test_attitude_estimation.py, testing_utils.py]
2024-05-30 Switched to ruff formatting
2024-05-30 Added ruff linting, fixed linting errors
    [attitude_estimation.py, camera.py, camera_recorder.py, communication.py, config.py, image_processing.py, image_utils.py]
2024-05-30 Added docstyle checking to ruff, fixed errors
    [attitude_estimation.py, calibration.py, camera.py, communication.py, image_processing.py, image_utils.py, kalkam.py, main.py]
2024-05-30 Added more ruff linters, fixed linter errors
    [attitude_estimation.py, camera.py, communication.py, config.py, image_utils.py, kalkam.py, main.py, motor_alignment_evaluation.py]
2024-05-30 Added even more ruff linters, fixed linter errors
    [attitude_estimation.py, camera.py, camera_recorder.py, communication.py, config.py, kalkam.py, main.py]
2024-09-04 bugfix: added kwargs to QueueAbstractionClass
    [webutil.py]
2024-09-06 Fixed invalid analog gain
    [camera.py]
2024-09-06 Fixed typo in calibration_from_images
    [kalkam.py]
2024-09-06 Added get_state/refactoring in camera web gui
2024-09-07 Fixed ChArUco board detection for opencv >=4.7
    [kalkam.py]
2024-09-07 Updated raspberry pi installation guide
2024-09-08 Fixed some type checking errors
    [attitude_estimation.py, camera.py, communication.py, image_processing.py, image_utils.py, main.py, motor_alignment_evaluation.py, protocol.py]
2024-09-10 Added brightness button
2024-09-11 Added calibration saving
2024-10-02 Fixed typing for python3.10
    [attitude_estimation.py, camera.py, communication.py, main.py]
2024-10-06 Added persistent camera settings
2024-10-06 Added cargo installation to raspberry pi doc
2024-10-08 Fixed camera settings at startup
    [camera.py, rpi.py]
2024-10-08 Added automatic camera settings safing
2024-10-11 Added star observations to camera webgui
2024-10-11 Added tracked stars overview to camera webgui
2024-10-13 Fused camera webgui and axis align into one gui
2024-10-22 Added camera calibration from star observations
2025-05-08 Updated ruff rules, fixed ruff errors
    [attitude_estimation.py, build_project.py, camera.py, camera_recorder.py, communication.py, kalkam.py, main.py, motor_alignment_evaluation.py]
2025-05-09 Properly terminated threads
2025-05-24 Added second calibration with percentile filter
2025-05-27 Changed optimizer to LM as better suited for the problem
    [starcamcal.py]
2025-05-29 Reimplemented calibration optimization problem in rust with 5000x speedup
    [build_project.py, deriv.py, lib.rs, starcal.rs, starcamcal.py]
2025-05-29 Add poisson disk sampling for even calibration sample distribution
2025-05-30 Added missing rotation degrees of freedom to starcamcal
    [deriv.py, lib.rs, starcal.rs, starcamcal.py]
2025-06-03 Reimplemented star gradient calibration in rust. Cleaned up workflow. Removed JAX dependency
2025-06-05 Added intrinsic star calibration demo
2025-06-07 Integrated star camera calibration into gui
2025-06-09 Fixed typing errors, added mypy checks to almost all modules, improved structure, tests
    [attitude_estimation.py, camera_recorder.py, communication.py, config.py, deriv.py, image_processing.py, initial_starcal.py, intrinsic_starcal_demo.py]
2025-06-10 Added axis align calibration test
2025-06-11 Improved Raspberry Pi camera capture, fixed small bugs
    [camera.py, rpi.py, testing_utils.py, web_gui.py]
2025-06-15 Added Settings and fullscreen button, cleaned up design
2025-08-18 Refined automatic star calibration, added demo
2025-08-18 Switched from json to msg pack for performance
2025-08-19 Removed random generator for real camera
2025-08-19 Improved switch between cam and cam_mock
2025-08-19 Implemented camera acquisition thread
2025-08-19 Fixed real camera_thread. Added python Camera class
    [cam.rs, cam_thread.rs, cam_thread_mock.rs, lib.rs, rust_cam.py]
2025-08-19 Fixed camera, added binning
    [cam.rs, cam_thread.rs, cam_thread_mock.rs]
2025-08-19 Added frame aplification and binning, CameraConfig
2025-08-19 Added camera config controls
2025-08-19 Added camera parameter setting
2025-08-19 Camera get dimensions from config
2025-08-19 Added camera and stream dispatcher to webserver
2025-08-19 Switched to rmp-serde
2025-08-21 Added axis calibration
2025-08-27 Integrated axis calibration
2025-09-05 Added shutdown returncode and darkframe correction
    [app.rs, cam.rs, webserver.rs]
2025-09-25 Added serial to communicate with raspberry pi
2025-09-26 Fixed blocking serial ports
    [app.rs, serial.rs]
2025-09-27 Fixed stm32 serial, fixed quaternion correction
    [app.rs, attitude_history.rs, communication.py, gyro.cpp, gyro.h, quat.h, rpi.h, serial.cpp]
2025-09-28 Fixed motion, fixed half frame rate of camera
    [app.rs, attitude_history.rs, cam_thread.rs]
2025-10-03 Fixed quaternion stream from stm
    [app.rs, application.cpp, attitude_estimation.rs, attitude_history.rs, rpi.h, serial.rs, testing_utils.py]
2025-10-03 Added scale and bias filter for gyro calibration
2025-10-05 Added gyro calibration
